JeyaVardhan-L/Single-Thrust-Vector-Controlled-Rocket/docs/glossary.md

# Glossary

| Term | Meaning |
|---|---|
| **AHRS** | Attitude and Heading Reference System: estimates orientation from gyro and accelerometer (here Mahony filter) |
| **Abort** | Software state entered on tilt > 35°, link loss, disarm or a fault in flight: motors cut, gimbal centred |
| **Backlash** | Free play between gear teeth or in a joint; shows up as dead-band in the thrust vector |
| **BEC** | Battery Eliminator Circuit: regulator that makes 5 V or 6 V from the flight battery |
| **CG / CP** | Centre of gravity / centre of pressure |
| **CRSF** | Crossfire serial protocol used by ExpressLRS receivers |
| **ELRS** | ExpressLRS, open-source RC link |
| **ESC** | Electronic speed controller for a brushless motor |
| **FRD** | Forward-Right-Down body axes |
| **FC** | Flight computer (Teensy 4.1 + sensors here) |
| **Gate** | A go / no-go checkpoint with written criteria |
| **Gimbal** | Two-axis pivot that swings the motor assembly to vector the thrust |
| **Coaxial pair** | Two motors on one axis with props turning in opposite directions, so their reaction torques cancel |
| **I (inertia)** | Moment of inertia about the pitch/yaw axis, kg·m² |
| **IMU** | Inertial measurement unit: gyro + accelerometer |
| **KV** | Motor constant, rpm per volt (no load) |
| **L (lever arm)** | Distance from the gimbal pivot to the CG |
| **LiPo** | Lithium-polymer battery |
| **Mahony filter** | Complementary attitude filter using accelerometer to correct gyro integration |
| **Mixer** | Maps roll/pitch/yaw commands to individual actuator commands |
| **PID** | Proportional-integral-derivative controller |
| **PLA / PETG / PA-CF** | 3D printing materials. PA-CF: nylon with carbon fibre |
| **RBF** | Remove-before-flight pin or loop that keeps the vehicle inert |
| **RSO** | Range Safety Officer |
| **Slew rate** | Maximum speed of an actuator, deg/s |
| **Thrust-to-weight (TWR)** | Thrust divided by weight |
| **TVC** | Thrust vector control |
| **Vane (jet vane)** | Control surface in the propeller or exhaust flow that deflects it sideways |
| **Wash** | The accelerated air stream behind a propeller |
