JeyaVardhan-L/Single-Thrust-Vector-Controlled-Rocket/assets/screenshots/monocopter-exploded.png

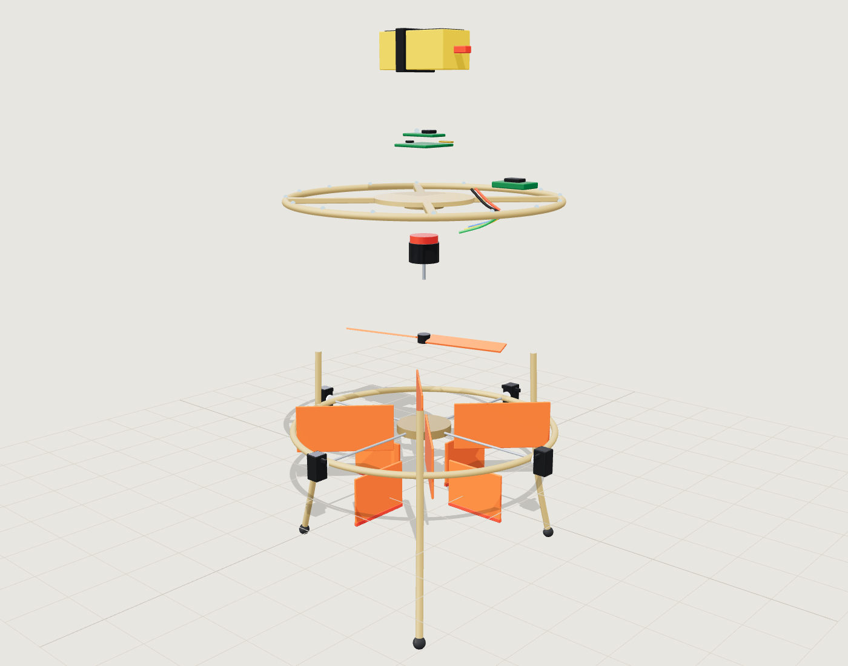
assets/screenshots/monocopter-exploded.png
