JeyaVardhan-L/Single-Thrust-Vector-Controlled-Rocket/assets/screenshots/ui-gimbal.png

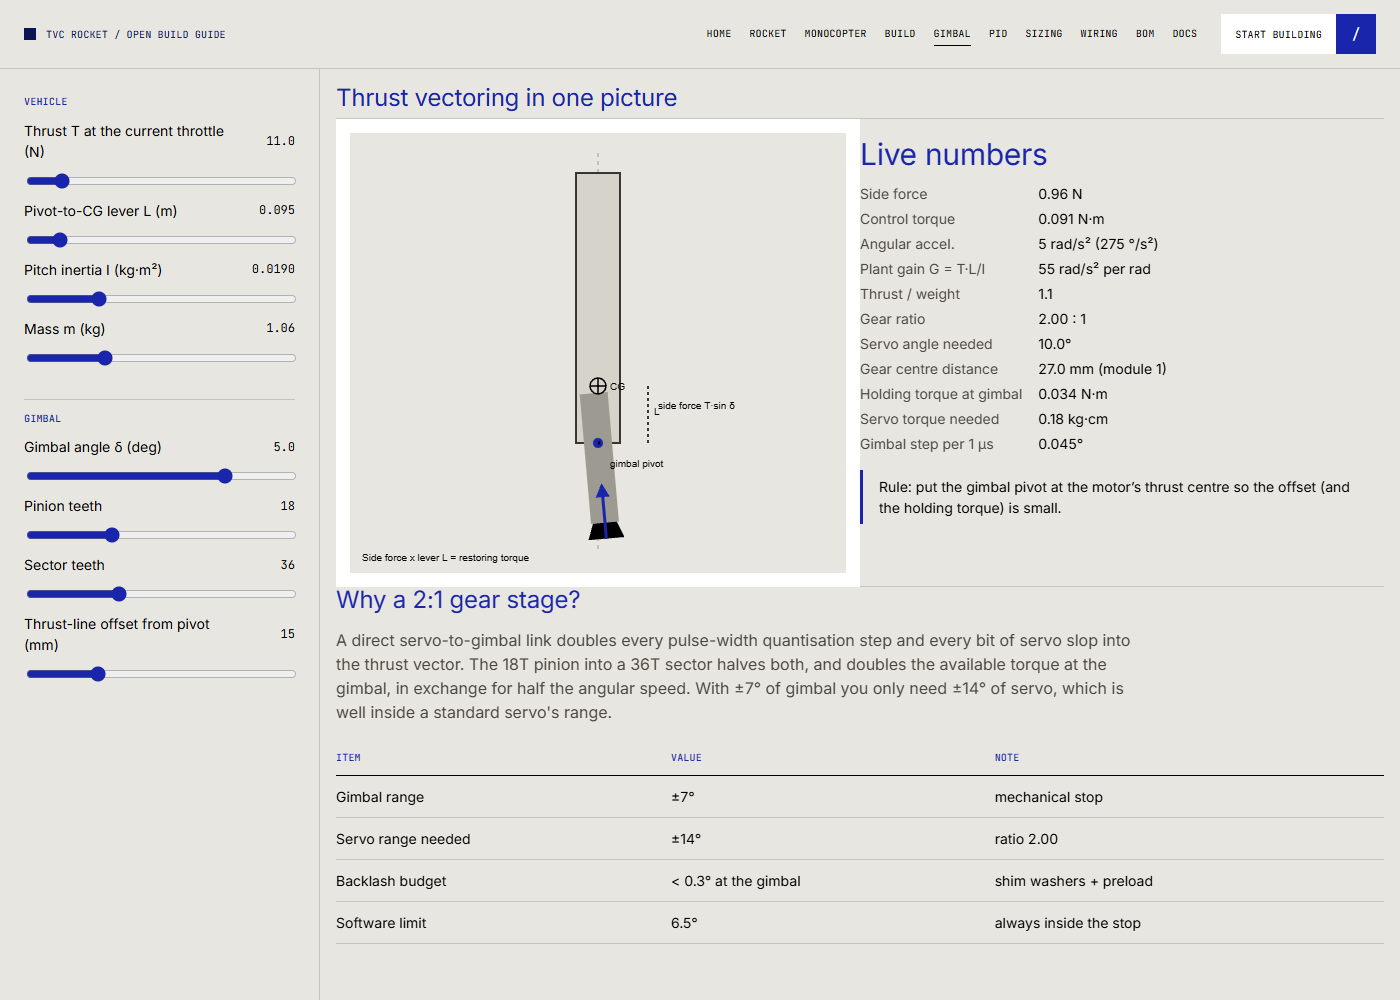
assets/screenshots/ui-gimbal.png
