JeyaVardhan-L/Single-Thrust-Vector-Controlled-Rocket/assets/screenshots/ui-index.png

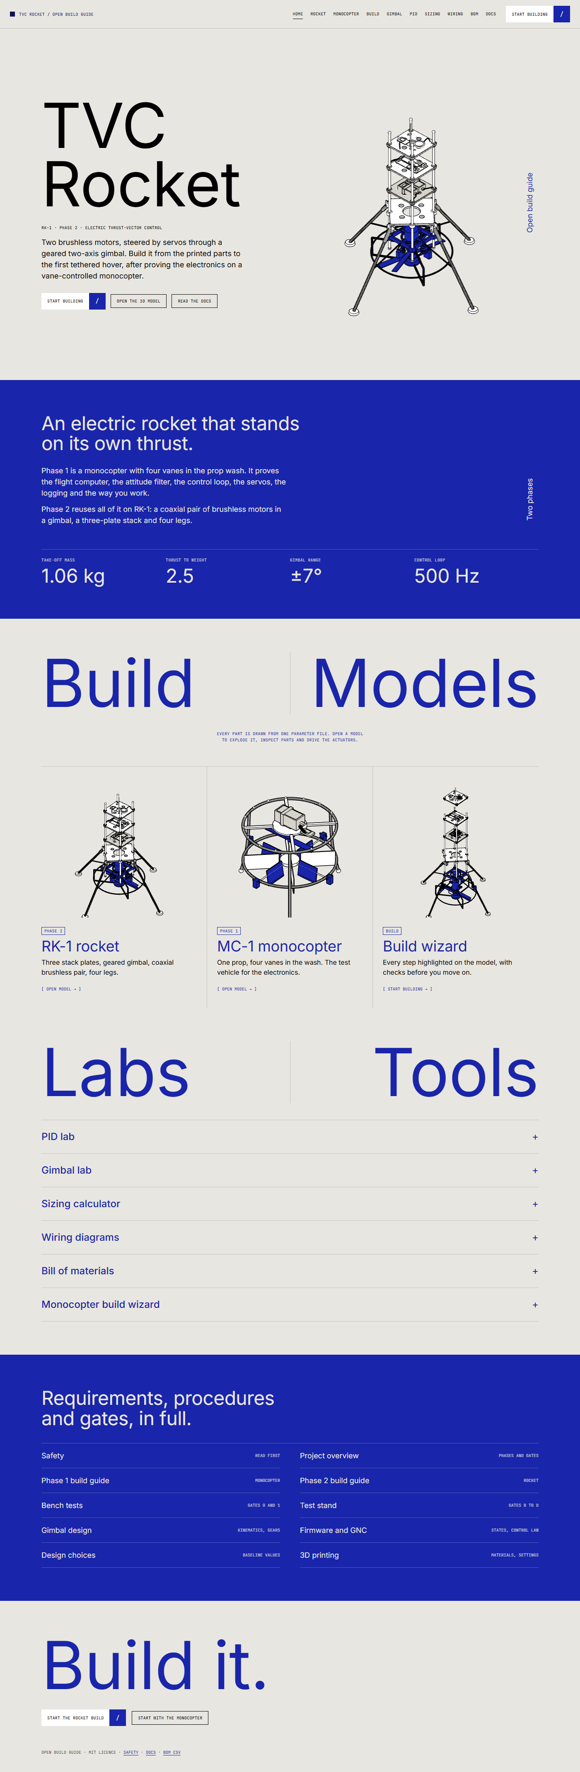
assets/screenshots/ui-index.png
