JeyaVardhan-L/Single-Thrust-Vector-Controlled-Rocket/assets/screenshots/ui-monocopter.png

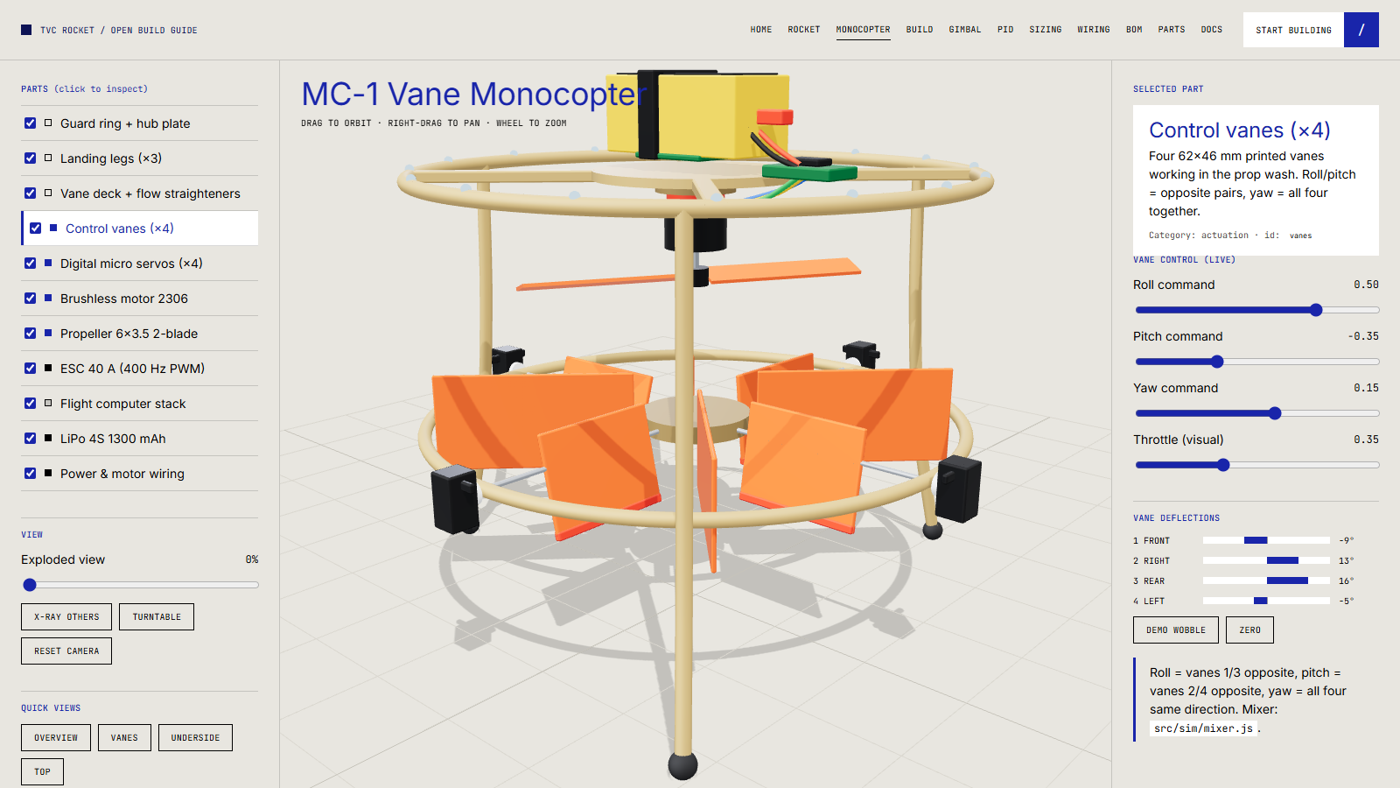
assets/screenshots/ui-monocopter.png
