JeyaVardhan-L/Single-Thrust-Vector-Controlled-Rocket/assets/screenshots/ui-pid.png

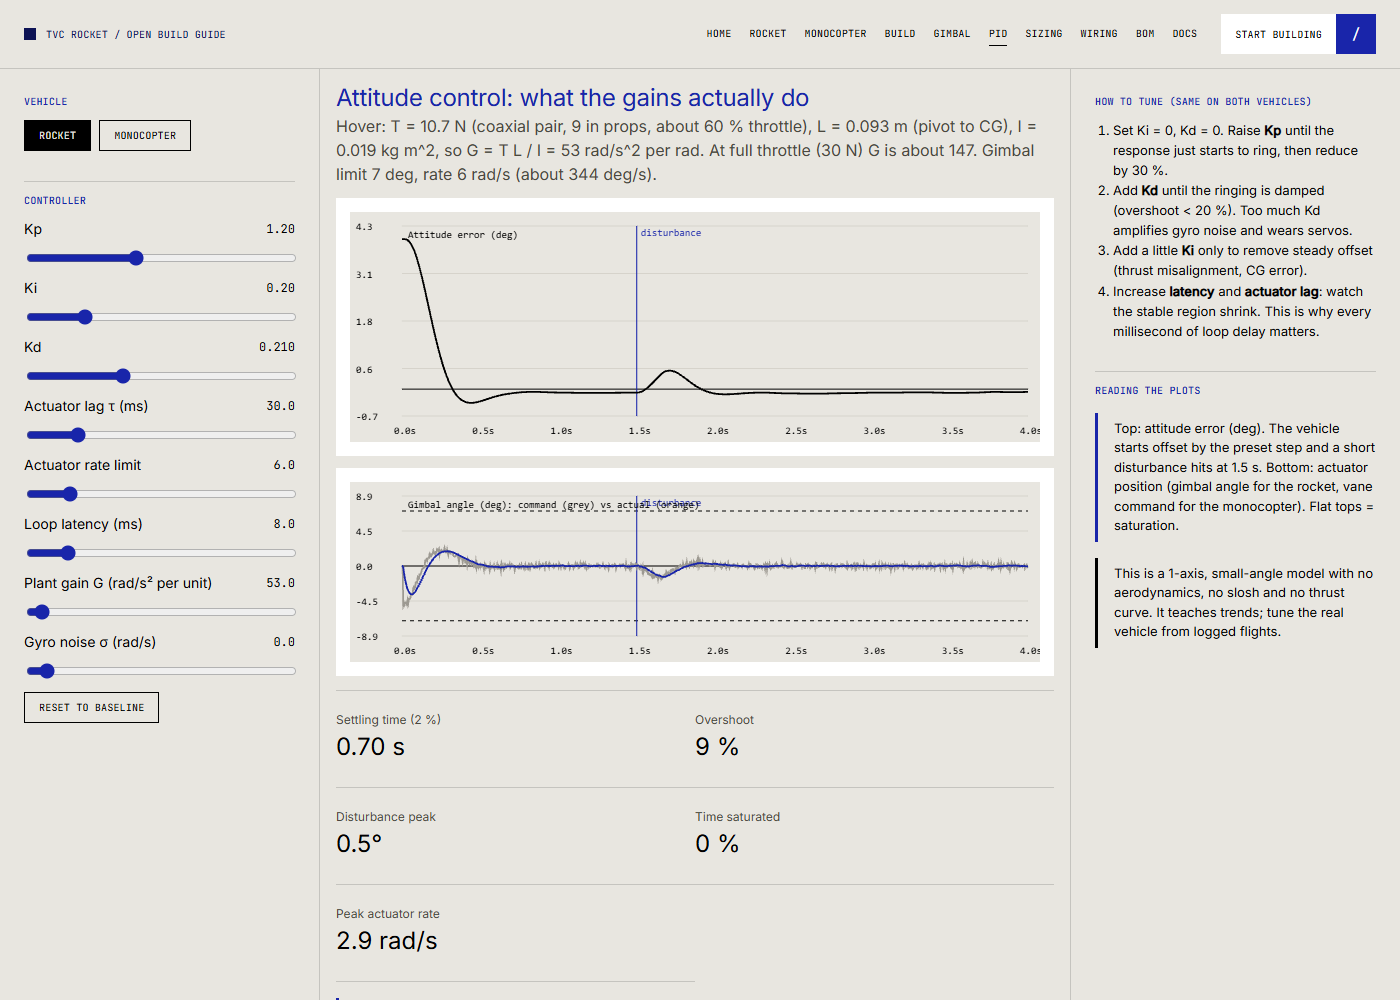
assets/screenshots/ui-pid.png
