JeyaVardhan-L/Single-Thrust-Vector-Controlled-Rocket/assets/screenshots/ui-rocket.png

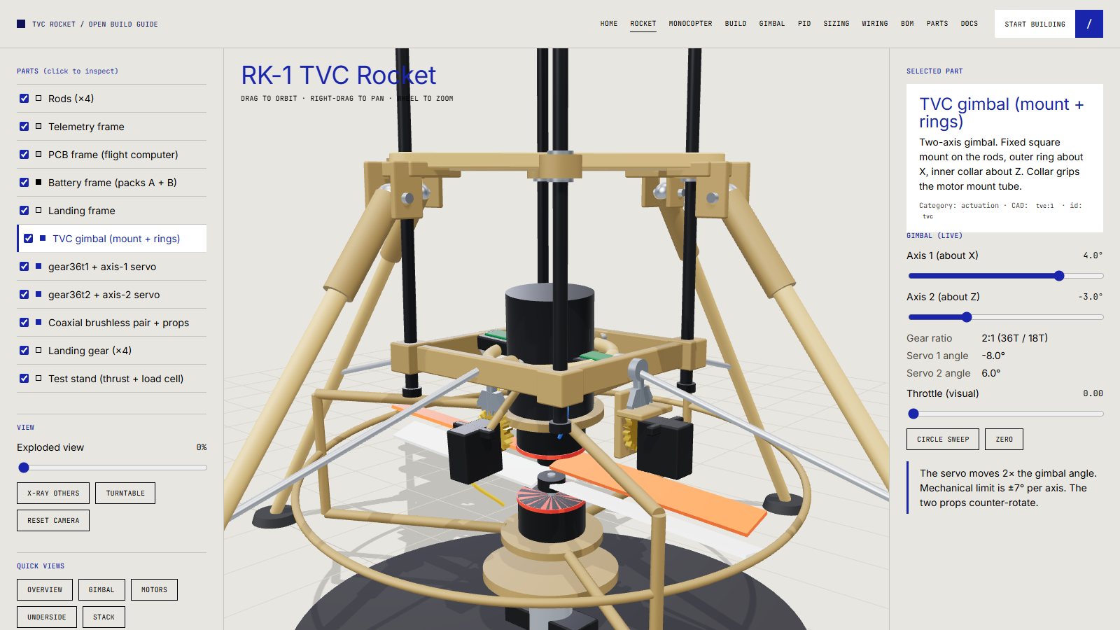
assets/screenshots/ui-rocket.png
