JeyaVardhan-L/Single-Thrust-Vector-Controlled-Rocket/assets/screenshots/ui-sizing.png

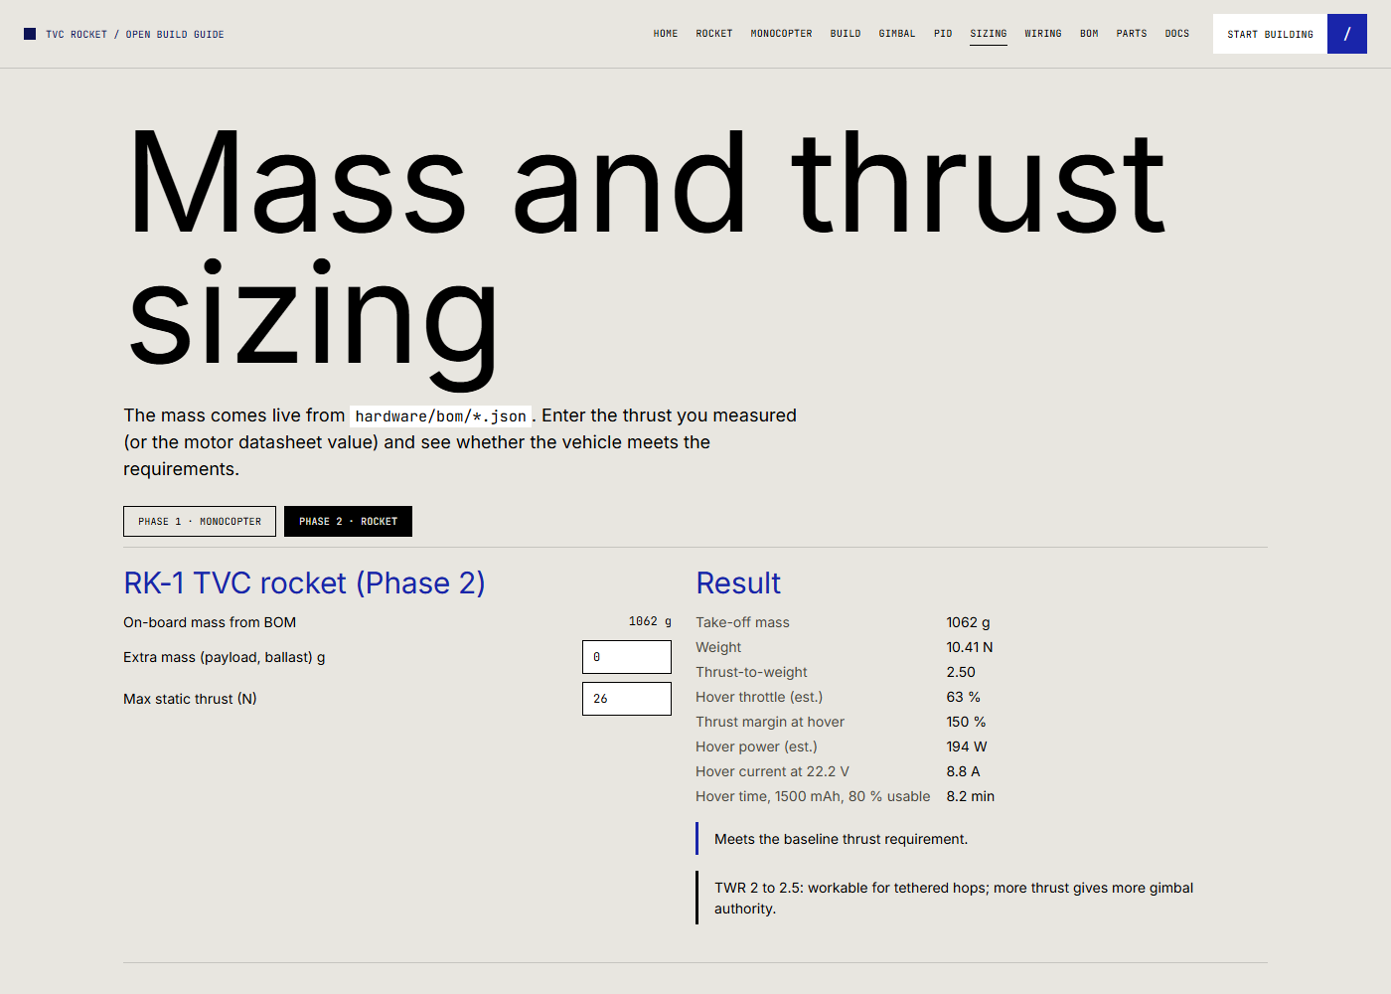
assets/screenshots/ui-sizing.png
