JeyaVardhan-L/Single-Thrust-Vector-Controlled-Rocket/docs/cad-parts.md

# Printable parts (STL)

Generated by `npm run cad` from [`scripts/cad/`](../scripts/cad/). Every file is a watertight solid in **millimetres**, already in its **print orientation** (z up, lowest face on the bed). Sizes are bounding boxes in that orientation. "g solid" is the mass if the part were printed 100 % solid, an upper bound: at the baseline settings (4 walls, 30 to 40 % infill) a part weighs roughly 55 to 80 % of it. Weigh the printed parts and update the BOM if a line differs by more than 10 % (see [printing guide](printing.md), post-processing step 6).

The smallest bed that fits everything is **220 × 220 mm**. Settings, materials and tolerances: [3D printing guide](printing.md).

## RK-1 rocket

| Part (STL) | Qty | Size (mm) | Material | g solid | BOM | Notes |
|---|---|---|---|---|---|---|
| [stack-plate-telemetry](../hardware/cad/stl/rocket/stack-plate-telemetry.stl) | 1 | 110 × 110 × 8 | PETG | 56 | R-02 | Ø6.2 rod holes with M3 clamp screws and nut slots; three M3 insert holes for the receiver / GPS standoffs. |
| [stack-plate-pcb](../hardware/cad/stl/rocket/stack-plate-pcb.stl) | 1 | 110 × 110 × 8 | PETG | 56 | R-02 | Four M3 insert holes at (±38, ±22) for the 9 mm standoffs under the carrier board. |
| [stack-plate-battery](../hardware/cad/stl/rocket/stack-plate-battery.stl) | 1 | 110 × 110 × 8 | PETG | 57 | R-02 | Two strap slots 12 × 3 mm at y = ±36. |
| [landing-frame](../hardware/cad/stl/rocket/landing-frame.stl) | 1 | 208 × 208 × 26.5 | PA-CF (or PETG for a first set) | 107 | R-03 | Printed upside down so the clevis ears point up. Hinge bore Ø3.2 for an M3 bolt. |
| [gimbal-mount](../hardware/cad/stl/rocket/gimbal-mount.stl) | 1 | 110 × 110 × 14 | PA-CF (or PETG for a first set) | 84 | G-01 | Carries the outer ring on two M3 pivots (X axis), the servo-1 bracket underneath and four leg-brace anchor holes. |
| [gimbal-ring](../hardware/cad/stl/rocket/gimbal-ring.stl) | 1 | 82 × 76 × 25 | PA-CF (or PETG for a first set) | 19 | G-01, G-02 | Printed upside down: sector fin points up. Two 683ZZ bearings in the X bosses; Y pads carry the collar pivots. Ream the Ø7 bearing bores. |
| [gimbal-collar](../hardware/cad/stl/rocket/gimbal-collar.stl) | 1 | 50 × 59.2 × 32 | PA-CF (or PETG for a first set) | 18 | G-01, G-02 | Clamps the Ø42 tube with four M3 set screws. Two 683ZZ bearings in the Y bosses. |
| [pinion-18t](../hardware/cad/stl/rocket/pinion-18t.stl) | 2 | 19.99 × 19.78 × 4 | PA12 / acetal (or metal) | 1 | G-02 | Ø4.7 bore for the 25T servo spline. Rotate on the spline until it meshes (gap centred on the sector tooth). |
| [servo-bracket-1](../hardware/cad/stl/rocket/servo-bracket-1.stl) | 1 | 31.5 × 36 × 14.5 | PA-CF (or PETG for a first set) | 5 | G-01 | Two M3 × 10 into the mount inserts; four M2 self-tap holes for a 23 × 12 mm servo. |
| [servo-bracket-2](../hardware/cad/stl/rocket/servo-bracket-2.stl) | 1 | 36 × 32.5 × 11.1 | PA-CF (or PETG for a first set) | 5 | G-01 | Two M3 × 10 into the ring inserts; four M2 self-tap holes for the servo. |
| [motor-plate-upper](../hardware/cad/stl/rocket/motor-plate-upper.stl) | 1 | 78.06 × 90.14 × 13 | PA-CF (or PETG for a first set) | 20 | M-05 | Ø42.3 socket for the carbon tube (epoxy + two M3 set screws). Motor pattern Ø19, four M3, reached through the tube bore. |
| [motor-plate-lower](../hardware/cad/stl/rocket/motor-plate-lower.stl) | 1 | 78.06 × 90.14 × 5 | PA-CF (or PETG for a first set) | 14 | M-05 | Motor B stands on it; screws from below. |
| [cage-arm-upper](../hardware/cad/stl/rocket/cage-arm-upper.stl) | 3 | 105 × 16 × 7.8 | PA-CF (or PETG for a first set) | 8 | M-05 | Half-lap onto the plate stub, two M3 × 12 with nuts; tip bolts to the strut. |
| [cage-arm-lower](../hardware/cad/stl/rocket/cage-arm-lower.stl) | 3 | 105 × 16 × 7.8 | PA-CF (or PETG for a first set) | 8 | M-05 | Same as the upper arm, on the lower plate. |
| [cage-strut](../hardware/cad/stl/rocket/cage-strut.stl) | 3 | 7.5 × 14 × 60 | PA-CF (or PETG for a first set) | 7 | M-05 | M3 inserts in both ends (screws M3 × 10 through the arms) and two on the outer face for the guard-ring tabs. |
| [guard-arc](../hardware/cad/stl/rocket/guard-arc.stl) | 3 | 195 × 125.98 × 10 | PETG | 9 | M-05 | Tabs screw onto the struts with M3 × 10. |
| [leg-hinge](../hardware/cad/stl/rocket/leg-hinge.stl) | 4 | 41.5 × 15 × 12.6 | PA-CF (or PETG for a first set) | 8 | R-04 | Ø8.2 socket for the Ø8 carbon leg (epoxy), Ø3.2 pin bore. Tongue 12.6 mm sits between the frame lug ears. |
| [leg-clip](../hardware/cad/stl/rocket/leg-clip.stl) | 4 | 27 × 18 × 10 | PETG | 3 | R-05 | Slides onto the leg, M3 grub screw; Ø2.2 eyelet for the Ø1.6 brace wire. |

Whole set printed solid: 583 g (upper bound).

## Hardware for the printed parts (RK-1)

| Item | Qty | Used at |
|---|---|---|
| M3 heat-set insert (Ø4.2 hole, 5.7 mm) | 23 | telemetry plate 3, PCB plate 4, gimbal mount 2, outer ring 2, cage struts 12 |
| M3 × 8 screw + M3 nut | 30 | rod clamps (3 plates, landing frame, mount: 20), collar set screws 4, motor plate socket 2, brace clips 4 |
| M3 × 20 bolt + M3 nylock nut | 2 | outer ring pivots (X axis) |
| M3 × 16 bolt + M3 nylock nut | 2 | collar pivots (Y axis) |
| M3 × 25 bolt + M3 nylock nut | 4 | leg hinges |
| M3 × 12 screw + M3 nut | 12 | cage arms to the plate stubs (two per arm) |
| M3 × 10 screw | 16 | servo brackets 4, arm tips to struts 6, guard-arc tabs 6 |
| M2 × 6 self-tapping screw | 8 | two servos, four per servo |
| 683ZZ bearing (3 × 7 × 3) | 4 | two in the outer ring bosses, two in the collar bosses |
| Carbon rod Ø6 × 400 mm | 4 | stack rods |
| Carbon rod Ø8 × 260 mm | 4 | legs |
| Carbon tube Ø42 (about 40 mm bore), 58 mm long | 1 | motor mount tube |
| Wire Ø1.6 mm | 4 | leg braces, about 135 mm each before the hooks |
