JeyaVardhan-L/Single-Thrust-Vector-Controlled-Rocket/docs/phase2-rocket/02-bom.md

<!-- GENERATED by scripts/gen-bom.mjs from hardware/bom/rocket.json. Edit the JSON, not this file. -->
# Bill of materials - Phase 2 - RK-1 TVC rocket

Masses are catalogue values; weigh each part as you build. Prices are indicative USD. Propulsion: coaxial contra-rotating brushless pair on a servo gimbal, see docs/design-choices.md.

| Total on-board mass | Total cost (all lines, indicative) |
|---|---|
| **1062 g** | **$746** |

Interactive version with live mass budget: [web/bom.html?model=rocket](../../web/bom.html?model=rocket). CSV: [rocket.csv](../../hardware/bom/rocket.csv).

## Structure

| ID | Item | Qty | Mass (g, each) | Price ($, each) | On-board | Specification / notes |
|---|---|---:|---:|---:|:---:|---|
| R-01 | Carbon-fibre rods, 6 mm x 400 mm | 4 | 23 | 4 | yes | Solid or thick-wall tube, 6 mm dia - Cut to 400 mm, deburr, seal ends with CA. |
| R-02 | Stack plates (battery, PCB, telemetry) | 3 | 22 | 3 | yes | PETG/PA-CF, 110 mm square, 4 mm thick - Print flat, 4 perimeters, 40% gyroid. |
| R-03 | Landing frame (diamond plate with four hinge lugs) | 1 | 38 | 4 | yes | PA-CF recommended: landing loads - 133 mm diamond, corners on the leg axes |
| R-04 | Landing legs 8 mm x 260 mm + rubber feet (hinge fittings printed) | 4 | 22 | 4 | yes | Carbon or aluminium tube, hinged at the corner lugs - 34 deg from vertical, footprint 510 mm |
| R-05 | Leg braces (1.6 mm steel or CF rod) | 4 | 3 | 1 | yes | From gimbal mount to leg mid-point |

## Gimbal

| ID | Item | Qty | Mass (g, each) | Price ($, each) | On-board | Specification / notes |
|---|---|---:|---:|---:|:---:|---|
| G-01 | Gimbal printed parts (mount, outer ring, collar, two servo brackets) | 1 | 48 | 6 | yes | PA-CF or machined 6061 aluminium - STL files in hardware/cad/stl/rocket. See docs/cad-parts.md. |
| G-02 | Pinion 18T, module 1 (printed PA12 / acetal, or metal) | 2 | 8 | 5 | yes | Acetal, nylon or printed PA; CAD names gear36t1 / gear36t2 - The two 36T sectors are printed into the outer ring and the collar. Check backlash; keep spares. |
| G-03 | Digital metal-gear servo, 20 g class, HV | 2 | 22 | 18 | yes | >= 4.5 kg.cm @ 7.4 V, <= 0.08 s/60 deg, 6-8.4 V rated - Buy a spare. |
| G-04 | Pivot hardware: M3 bolts (2 x 20 mm, 2 x 16 mm), nylock nuts, 683ZZ bearings | 4 | 3 | 1 | yes | Stainless button-head M3, 3x7x3 mm bearings (one per pivot) - Bolt is clamped to the fixed part, the bearing rides in the moving boss. Tighten until the bearing just drags, back off 1/8 turn. |
| G-05 | Service-loop cable for servo 2 | 1 | 3 | 1 | yes | Silicone wire, strain-relieved - Servo 2 rides on the outer ring. |

## Propulsion

| ID | Item | Qty | Mass (g, each) | Price ($, each) | On-board | Specification / notes |
|---|---|---:|---:|---:|:---:|---|
| M-01 | Brushless motor 3110, about 900 KV (coaxial pair) | 2 | 82 | 38 | yes | 6S rated, 5 mm shaft, prop adapters for CW and CCW - Static thrust about 1.5 kgf each with a 9 in prop on 6S (recorded on the stand at Gate B). |
| M-02 | Propellers 9x4.5, one CW and one CCW | 2 | 13 | 6 | yes | Matched pair, balanced. Upper prop (below its motor) is a pusher type, lower prop (above its motor) is a standard type; both blow air downward - Contra-rotating pair: reaction torques cancel. |
| M-03 | Spare propellers 9x4.5 (2 CW + 2 CCW) | 4 | 13 | 6 | no | Same as M-02 - The first crash breaks one. |
| M-04 | ESC 40 A, 6S, 400 Hz PWM (BLHeli_S / AM32) | 2 | 12 | 20 | yes | One per motor - Set the directions in the configurator before the first spin. |
| M-05 | Motor mount: Ø42 carbon tube, printed plates, arms, struts and guard ring | 1 | 52 | 10 | yes | Carbon tube 58 mm + printed plates, 3 struts and a Ø246 mm guard ring - Holds motor A above the props and motor B below. |
| M-06 | Power distribution board + 1000 uF 35 V capacitors + XT60 | 1 | 12 | 8 | yes | Two ESC feeds, capacitor close to each ESC |

## Power

| ID | Item | Qty | Mass (g, each) | Price ($, each) | On-board | Specification / notes |
|---|---|---:|---:|---:|:---:|---|
| E-01 | LiPo 6S 1500 mAh, 75C+, XT60 (main pack) | 1 | 215 | 42 | yes | 22.2 V nominal, 25.2 V full - Feeds the ESCs and, through BECs, the servos. |
| E-02 | LiPo 2S 450 mAh (avionics pack) | 1 | 35 | 9 | yes | 7.4 V nominal - Keeps the flight computer and log alive and electrically isolated from ESC noise. |
| E-03 | Servo BEC 7.4 V / 5 A (from the 6S pack) | 1 | 12 | 10 | yes | Switching regulator, input 6S, output 7.4 V - Servos are HV rated. |
| E-04 | 5 V / 3 A regulator (logic, from the 2S pack) | 1 | 5 | 6 | yes |  |
| E-05 | Fuse 5 A (servo BEC) + remove-before-flight pin + arm switch | 1 | 8 | 6 | yes | RBF pin breaks the main-pack supply: removable with gloves |
| E-06 | Wiring harness, connectors, heat shrink | 1 | 30 | 10 | yes | 12-14 AWG motor and power leads, 26-28 AWG signals, locking connectors - No bare Dupont connectors on a rocket: vibration. |

## Avionics

| ID | Item | Qty | Mass (g, each) | Price ($, each) | On-board | Specification / notes |
|---|---|---:|---:|---:|:---:|---|
| A-01 | Teensy 4.1 | 1 | 4 | 32 | yes |  |
| A-02 | IMU ICM-42688-P | 1 | 2 | 15 | yes | SPI, +-2000 dps, +-16 g - Mount near the stack axis. |
| A-03 | Barometer BMP390 | 1 | 1 | 8 | yes | Vent the frame; avoid sealed cavities. |
| A-04 | ExpressLRS 2.4 GHz receiver + antenna | 1 | 2 | 14 | yes | CRSF over UART, link statistics on the radio - Antenna on the top plate, clear of the carbon rods. |
| A-05 | GPS u-blox M10 module | 1 | 8 | 18 | yes | UART, 10 Hz - Top plate, antenna clear of carbon rods. |
| A-06 | Buzzer + status LEDs | 1 | 2 | 3 | yes |  |
| A-07 | microSD card | 1 | 0.5 | 6 | yes | FAT32/exFAT, 500 Hz logging - Logs are how you tune. |

## Hardware

| ID | Item | Qty | Mass (g, each) | Price ($, each) | On-board | Specification / notes |
|---|---|---:|---:|---:|:---:|---|
| H-01 | Fasteners (M3/M4/M5, nylock, washers, inserts) | 1 | 40 | 14 | yes | Counts per part are in docs/cad-parts.md (hardware list). About 23 M3 inserts, 75 M3 screws, 50 M3 nuts (8 nylock). |

## Test equipment

| ID | Item | Qty | Mass (g, each) | Price ($, each) | On-board | Specification / notes |
|---|---|---:|---:|---:|:---:|---|
| T-01 | Test stand: base, column, 20 kg load cell + HX711 | 1 | 0 | 45 | no | Steel/aluminium, anchored - See docs/phase2-rocket/07-test-stand-procedure.md |
| T-02 | Prop shield: polycarbonate panel or net cage | 1 | 0 | 25 | no | Between people and the props - Props shed fragments. |
| T-03 | Current-limited bench supply or smoke stopper | 1 | 0 | 25 | no | Limit to 2-3 A for the first power-up |
| T-04 | ELRS transmitter / radio | 1 | 0 | 80 | no | Any EdgeTX radio with an ELRS module - Skip if you already own one. |
| T-05 | Balance charger + LiPo safe bag (6S capable) | 1 | 0 | 50 | no |  |
| T-06 | Tether kit: 3 x 3 m line, anchors, swivel | 1 | 0 | 12 | no | Rated > 80 N |
| T-07 | Fire extinguisher, gloves, eye protection | 1 | 0 | 40 | no | Required at every powered test. |
