JeyaVardhan-L/Single-Thrust-Vector-Controlled-Rocket/docs/phase1-monocopter/02-bom.md

<!-- GENERATED by scripts/gen-bom.mjs from hardware/bom/monocopter.json. Edit the JSON, not this file. -->
# Bill of materials - Phase 1 - MC-1 monocopter

Masses are catalogue values and prices are indicative USD (hobby market, vary by region and supplier). Weigh each part as you build and update this file; the sizing page and the docs are generated from it.

| Total on-board mass | Total cost (all lines, indicative) |
|---|---|
| **485 g** | **$475** |

Interactive version with live mass budget: [web/bom.html?model=monocopter](../../web/bom.html?model=monocopter). CSV: [monocopter.csv](../../hardware/bom/monocopter.csv).

## Propulsion

| ID | Item | Qty | Mass (g, each) | Price ($, each) | On-board | Specification / notes |
|---|---|---:|---:|---:|:---:|---|
| P-01 | Brushless motor 2306, 1900-2300 KV | 1 | 33 | 22 | yes | 2306 outrunner, 4S rated, prop adapter, 16x16 or 12x12 mm mount pattern - Static thrust is recorded on the thrust stand at Gate 1. |
| P-02 | Propeller 6x3.5 two-blade (spares) | 3 | 6 | 2 | no | 6 in two-blade pusher type (air leaves away from the motor), rotation matched to the motor, balanced - Always keep spares: the first crash breaks one. |
| P-03 | Propeller (mounted) | 1 | 6 | 0 | yes | see P-02 - Balance with a prop balancer or tape trim. |
| P-04 | ESC 40 A, 4S, DShot (BLHeli_S / AM32) | 1 | 10 | 25 | yes | Single-motor ESC, DShot300/600 - Set motor direction in the configurator before the first spin. |

## Power

| ID | Item | Qty | Mass (g, each) | Price ($, each) | On-board | Specification / notes |
|---|---|---:|---:|---:|:---:|---|
| E-01 | LiPo 4S 1300 mAh, 75C+, XT60 | 1 | 155 | 28 | yes | 14.8 V nominal, 16.8 V full - Buy 2-3 packs. Store at 3.8 V per cell. |
| E-02 | Servo BEC 6.0 V / 5 A | 1 | 12 | 9 | yes | Switching regulator, input 2S-6S, output 6.0 V >= 5 A peak - Four digital servos can pull 3-4 A together at stall. |
| E-03 | Logic BEC 5 V / 3 A | 1 | 6 | 6 | yes | Low-noise 5 V for Teensy, IMU, receiver - Separate from the servo rail to avoid brown-outs. |
| E-04 | Power leads, XT60 pair, 14 AWG silicone | 1 | 14 | 6 | yes | Battery lead to ESC with 1000 uF 35 V low-ESR cap - Solder carefully; this is the highest-current joint. |
| E-05 | Arming switch + remove-before-flight loop | 1 | 5 | 5 | yes | XT30 loop or anti-spark switch in the battery lead - Nothing powers up until the loop is inserted. |
| E-06 | Voltage/current sensor (INA226 breakout) | 1 | 2 | 4 | yes | I2C, 36 V, shunt rated >= 40 A, or use ESC telemetry - Needed for battery-low cut and power logging. |

## Avionics

| ID | Item | Qty | Mass (g, each) | Price ($, each) | On-board | Specification / notes |
|---|---|---:|---:|---:|:---:|---|
| A-01 | Teensy 4.1 (with microSD slot) | 1 | 4 | 32 | yes | 600 MHz Cortex-M7, 3 SPI, 3 I2C, 8 UART - Same MCU as the rocket: Phase 1 de-risks the software. |
| A-02 | IMU ICM-42688-P breakout | 1 | 2 | 15 | yes | 6-axis, SPI, gyro +-2000 dps, accel +-16 g - Mount on foam standoffs at the CG, away from the motor. |
| A-03 | Barometer BMP390 breakout | 1 | 1 | 8 | yes | I2C/SPI, +-0.5 m relative - Cover with open-cell foam against prop-wash noise. |
| A-04 | ExpressLRS 2.4 GHz receiver | 1 | 1 | 14 | yes | CRSF over UART, telemetry back-channel - Needs a matching ELRS transmitter module/radio (ground equipment). |
| A-05 | microSD card 8-32 GB, class 10 | 1 | 0.5 | 6 | yes | FAT32/exFAT, flight log at 500 Hz - Logs are how you tune. Never fly without logging. |
| A-06 | Carrier board / perfboard + headers | 1 | 8 | 5 | yes | 70x70 mm max, female headers for the Teensy - Replace with a custom PCB once the pinout is frozen. |
| A-07 | Buzzer + status LEDs | 1 | 2 | 3 | yes | 5 V active buzzer, 3x LED - Audible arming state and low-battery alarm. |

## Actuation

| ID | Item | Qty | Mass (g, each) | Price ($, each) | On-board | Specification / notes |
|---|---|---:|---:|---:|:---:|---|
| S-01 | Digital metal-gear micro servo (9-13 g) | 4 | 13 | 9 | yes | >= 2.0 kg.cm at 6 V, <= 0.10 s/60 deg, 6 V rated, metal gear - Matched pairs for roll/pitch are a bonus. |
| S-02 | Servo spare | 1 | 13 | 9 | no | same as S-01 |
| S-03 | Vane hinge shaft, steel 2 mm x 110 mm | 4 | 3 | 1 | yes | 2 mm drill rod or carbon pin, cut to length - Servo horn clamps one end; vane clamps the shaft with an M2 grub screw. |

## Structure

| ID | Item | Qty | Mass (g, each) | Price ($, each) | On-board | Specification / notes |
|---|---|---:|---:|---:|:---:|---|
| F-01 | 3D-printed parts (PETG or PA-CF) | 1 | 105 | 12 | yes | Ring, hub, deck, vanes, legs, battery tray (see docs/printing.md) - Print legs in TPU or thin PETG for compliance. |
| F-02 | M3 stainless hardware kit + nylock nuts | 1 | 18 | 8 | yes | M3 x 6/8/12/16, washers, nylock |
| F-03 | M3 brass heat-set inserts | 40 | 0.1 | 0.12 | yes | M3 x 5.7 mm - Use a soldering iron with an insert tip. |
| F-04 | M2 screws + servo horn hardware | 1 | 3 | 3 | yes | M2 x 6/8, grub screws |
| F-05 | Battery strap 20 mm Velcro + foam pads | 1 | 4 | 2 | yes |  |
| F-06 | Wire: 26-30 AWG silicone, zip ties, heat shrink | 1 | 25 | 8 | yes |  |

## Test equipment

| ID | Item | Qty | Mass (g, each) | Price ($, each) | On-board | Specification / notes |
|---|---|---:|---:|---:|:---:|---|
| T-01 | Thrust stand: 5 kg load cell + HX711 | 1 | 0 | 12 | no | Bench thrust and torque measurement - Needed for Gate 1 (static thrust and vane authority). |
| T-02 | Tether kit: 3x 3 m line, ground anchors, swivel | 1 | 0 | 12 | no | Three-line tether, > 40 N working load - Slack tether limits altitude and sideways drift. |
| T-03 | Polycarbonate shield or net cage | 1 | 0 | 25 | no | Between operator and prop on the bench - Props at 15k rpm shed blades. |
| T-04 | Current-limited bench supply or smoke stopper | 1 | 0 | 25 | no | Limit to 2-3 A for first power-up - Protects against wiring shorts. |
| T-05 | LiPo safe bag + balance charger | 1 | 0 | 40 | no | 4S balance charger, fire-resistant bag |
| T-06 | ELRS transmitter / radio | 1 | 0 | 80 | no | Any EdgeTX radio with an ELRS module - Skip if you already own one. |
