JeyaVardhan-L/Single-Thrust-Vector-Controlled-Rocket/hardware/bom/rocket.csv

id | category | name | qty | onboard | unit_mass_g | unit_price_usd | line_mass_g | line_price_usd | spec | notes
R-01 | Structure | Carbon-fibre rods, 6 mm x 400 mm | 4 | yes | 23 | 4 | 92 | 16 | Solid or thick-wall tube, 6 mm dia | Cut to 400 mm, deburr, seal ends with CA.
R-02 | Structure | Stack plates (battery, PCB, telemetry) | 3 | yes | 22 | 3 | 66 | 9 | PETG/PA-CF, 110 mm square, 4 mm thick | Print flat, 4 perimeters, 40% gyroid.
R-03 | Structure | Landing frame (diamond plate with four hinge lugs) | 1 | yes | 38 | 4 | 38 | 4 | PA-CF recommended: landing loads | 133 mm diamond, corners on the leg axes
R-04 | Structure | Landing legs 8 mm x 260 mm + rubber feet (hinge fittings printed) | 4 | yes | 22 | 4 | 88 | 16 | Carbon or aluminium tube, hinged at the corner lugs | 34 deg from vertical, footprint 510 mm
R-05 | Structure | Leg braces (1.6 mm steel or CF rod) | 4 | yes | 3 | 1 | 12 | 4 | From gimbal mount to leg mid-point
G-01 | Gimbal | Gimbal printed parts (mount, outer ring, collar, two servo brackets) | 1 | yes | 48 | 6 | 48 | 6 | PA-CF or machined 6061 aluminium | STL files in hardware/cad/stl/rocket. See docs/cad-parts.md.
G-02 | Gimbal | Pinion 18T, module 1 (printed PA12 / acetal, or metal) | 2 | yes | 8 | 5 | 16 | 10 | Acetal, nylon or printed PA; CAD names gear36t1 / gear36t2 | The two 36T sectors are printed into the outer ring and the collar. Check backlash; keep spares.
G-03 | Gimbal | Digital metal-gear servo, 20 g class, HV | 2 | yes | 22 | 18 | 44 | 36 | >= 4.5 kg.cm @ 7.4 V, <= 0.08 s/60 deg, 6-8.4 V rated | Buy a spare.
G-04 | Gimbal | Pivot hardware: M3 bolts (2 x 20 mm, 2 x 16 mm), nylock nuts, 683ZZ bearings | 4 | yes | 3 | 1 | 12 | 4 | Stainless button-head M3, 3x7x3 mm bearings (one per pivot) | Bolt is clamped to the fixed part, the bearing rides in the moving boss. Tighten until the bearing just drags, back off 1/8 turn.
G-05 | Gimbal | Service-loop cable for servo 2 | 1 | yes | 3 | 1 | 3 | 1 | Silicone wire, strain-relieved | Servo 2 rides on the outer ring.
M-01 | Propulsion | Brushless motor 3110, about 900 KV (coaxial pair) | 2 | yes | 82 | 38 | 164 | 76 | 6S rated, 5 mm shaft, prop adapters for CW and CCW | Static thrust about 1.5 kgf each with a 9 in prop on 6S (recorded on the stand at Gate B).
M-02 | Propulsion | Propellers 9x4.5, one CW and one CCW | 2 | yes | 13 | 6 | 26 | 12 | Matched pair, balanced. Upper prop (below its motor) is a pusher type, lower prop (above its motor) is a standard type; both blow air downward | Contra-rotating pair: reaction torques cancel.
M-03 | Propulsion | Spare propellers 9x4.5 (2 CW + 2 CCW) | 4 | no | 13 | 6 | 0 | 24 | Same as M-02 | The first crash breaks one.
M-04 | Propulsion | ESC 40 A, 6S, 400 Hz PWM (BLHeli_S / AM32) | 2 | yes | 12 | 20 | 24 | 40 | One per motor | Set the directions in the configurator before the first spin.
M-05 | Propulsion | Motor mount: Ø42 carbon tube, printed plates, arms, struts and guard ring | 1 | yes | 52 | 10 | 52 | 10 | Carbon tube 58 mm + printed plates, 3 struts and a Ø246 mm guard ring | Holds motor A above the props and motor B below.
M-06 | Propulsion | Power distribution board + 1000 uF 35 V capacitors + XT60 | 1 | yes | 12 | 8 | 12 | 8 | Two ESC feeds, capacitor close to each ESC
E-01 | Power | LiPo 6S 1500 mAh, 75C+, XT60 (main pack) | 1 | yes | 215 | 42 | 215 | 42 | 22.2 V nominal, 25.2 V full | Feeds the ESCs and, through BECs, the servos.
E-02 | Power | LiPo 2S 450 mAh (avionics pack) | 1 | yes | 35 | 9 | 35 | 9 | 7.4 V nominal | Keeps the flight computer and log alive and electrically isolated from ESC noise.
E-03 | Power | Servo BEC 7.4 V / 5 A (from the 6S pack) | 1 | yes | 12 | 10 | 12 | 10 | Switching regulator, input 6S, output 7.4 V | Servos are HV rated.
E-04 | Power | 5 V / 3 A regulator (logic, from the 2S pack) | 1 | yes | 5 | 6 | 5 | 6
E-05 | Power | Fuse 5 A (servo BEC) + remove-before-flight pin + arm switch | 1 | yes | 8 | 6 | 8 | 6 | RBF pin breaks the main-pack supply: removable with gloves
E-06 | Power | Wiring harness, connectors, heat shrink | 1 | yes | 30 | 10 | 30 | 10 | 12-14 AWG motor and power leads, 26-28 AWG signals, locking connectors | No bare Dupont connectors on a rocket: vibration.
A-01 | Avionics | Teensy 4.1 | 1 | yes | 4 | 32 | 4 | 32
A-02 | Avionics | IMU ICM-42688-P | 1 | yes | 2 | 15 | 2 | 15 | SPI, +-2000 dps, +-16 g | Mount near the stack axis.
A-03 | Avionics | Barometer BMP390 | 1 | yes | 1 | 8 | 1 | 8 |  | Vent the frame; avoid sealed cavities.
A-04 | Avionics | ExpressLRS 2.4 GHz receiver + antenna | 1 | yes | 2 | 14 | 2 | 14 | CRSF over UART, link statistics on the radio | Antenna on the top plate, clear of the carbon rods.
A-05 | Avionics | GPS u-blox M10 module | 1 | yes | 8 | 18 | 8 | 18 | UART, 10 Hz | Top plate, antenna clear of carbon rods.
A-06 | Avionics | Buzzer + status LEDs | 1 | yes | 2 | 3 | 2 | 3
A-07 | Avionics | microSD card | 1 | yes | 0.5 | 6 | 0.5 | 6 | FAT32/exFAT, 500 Hz logging | Logs are how you tune.
H-01 | Hardware | Fasteners (M3/M4/M5, nylock, washers, inserts) | 1 | yes | 40 | 14 | 40 | 14 |  | Counts per part are in docs/cad-parts.md (hardware list). About 23 M3 inserts, 75 M3 screws, 50 M3 nuts (8 nylock).
T-01 | Test equipment | Test stand: base, column, 20 kg load cell + HX711 | 1 | no | 0 | 45 | 0 | 45 | Steel/aluminium, anchored | See docs/phase2-rocket/07-test-stand-procedure.md
T-02 | Test equipment | Prop shield: polycarbonate panel or net cage | 1 | no | 0 | 25 | 0 | 25 | Between people and the props | Props shed fragments.
T-03 | Test equipment | Current-limited bench supply or smoke stopper | 1 | no | 0 | 25 | 0 | 25 | Limit to 2-3 A for the first power-up
T-04 | Test equipment | ELRS transmitter / radio | 1 | no | 0 | 80 | 0 | 80 | Any EdgeTX radio with an ELRS module | Skip if you already own one.
T-05 | Test equipment | Balance charger + LiPo safe bag (6S capable) | 1 | no | 0 | 50 | 0 | 50
T-06 | Test equipment | Tether kit: 3 x 3 m line, anchors, swivel | 1 | no | 0 | 12 | 0 | 12 | Rated > 80 N
T-07 | Test equipment | Fire extinguisher, gloves, eye protection | 1 | no | 0 | 40 | 0 | 40 |  | Required at every powered test.
