JeyaVardhan-L/Single-Thrust-Vector-Controlled-Rocket/hardware/bom/monocopter.csv

id | category | name | qty | onboard | unit_mass_g | unit_price_usd | line_mass_g | line_price_usd | spec | notes
P-01 | Propulsion | Brushless motor 2306, 1900-2300 KV | 1 | yes | 33 | 22 | 33 | 22 | 2306 outrunner, 4S rated, prop adapter, 16x16 or 12x12 mm mount pattern | Static thrust is recorded on the thrust stand at Gate 1.
P-02 | Propulsion | Propeller 6x3.5 two-blade (spares) | 3 | no | 6 | 2 | 0 | 6 | 6 in two-blade pusher type (air leaves away from the motor), rotation matched to the motor, balanced | Always keep spares: the first crash breaks one.
P-03 | Propulsion | Propeller (mounted) | 1 | yes | 6 | 0 | 6 | 0 | see P-02 | Balance with a prop balancer or tape trim.
P-04 | Propulsion | ESC 40 A, 4S, DShot (BLHeli_S / AM32) | 1 | yes | 10 | 25 | 10 | 25 | Single-motor ESC, DShot300/600 | Set motor direction in the configurator before the first spin.
E-01 | Power | LiPo 4S 1300 mAh, 75C+, XT60 | 1 | yes | 155 | 28 | 155 | 28 | 14.8 V nominal, 16.8 V full | Buy 2-3 packs. Store at 3.8 V per cell.
E-02 | Power | Servo BEC 6.0 V / 5 A | 1 | yes | 12 | 9 | 12 | 9 | Switching regulator, input 2S-6S, output 6.0 V >= 5 A peak | Four digital servos can pull 3-4 A together at stall.
E-03 | Power | Logic BEC 5 V / 3 A | 1 | yes | 6 | 6 | 6 | 6 | Low-noise 5 V for Teensy, IMU, receiver | Separate from the servo rail to avoid brown-outs.
E-04 | Power | Power leads, XT60 pair, 14 AWG silicone | 1 | yes | 14 | 6 | 14 | 6 | Battery lead to ESC with 1000 uF 35 V low-ESR cap | Solder carefully; this is the highest-current joint.
E-05 | Power | Arming switch + remove-before-flight loop | 1 | yes | 5 | 5 | 5 | 5 | XT30 loop or anti-spark switch in the battery lead | Nothing powers up until the loop is inserted.
E-06 | Power | Voltage/current sensor (INA226 breakout) | 1 | yes | 2 | 4 | 2 | 4 | I2C, 36 V, shunt rated >= 40 A, or use ESC telemetry | Needed for battery-low cut and power logging.
A-01 | Avionics | Teensy 4.1 (with microSD slot) | 1 | yes | 4 | 32 | 4 | 32 | 600 MHz Cortex-M7, 3 SPI, 3 I2C, 8 UART | Same MCU as the rocket: Phase 1 de-risks the software.
A-02 | Avionics | IMU ICM-42688-P breakout | 1 | yes | 2 | 15 | 2 | 15 | 6-axis, SPI, gyro +-2000 dps, accel +-16 g | Mount on foam standoffs at the CG, away from the motor.
A-03 | Avionics | Barometer BMP390 breakout | 1 | yes | 1 | 8 | 1 | 8 | I2C/SPI, +-0.5 m relative | Cover with open-cell foam against prop-wash noise.
A-04 | Avionics | ExpressLRS 2.4 GHz receiver | 1 | yes | 1 | 14 | 1 | 14 | CRSF over UART, telemetry back-channel | Needs a matching ELRS transmitter module/radio (ground equipment).
A-05 | Avionics | microSD card 8-32 GB, class 10 | 1 | yes | 0.5 | 6 | 0.5 | 6 | FAT32/exFAT, flight log at 500 Hz | Logs are how you tune. Never fly without logging.
A-06 | Avionics | Carrier board / perfboard + headers | 1 | yes | 8 | 5 | 8 | 5 | 70x70 mm max, female headers for the Teensy | Replace with a custom PCB once the pinout is frozen.
A-07 | Avionics | Buzzer + status LEDs | 1 | yes | 2 | 3 | 2 | 3 | 5 V active buzzer, 3x LED | Audible arming state and low-battery alarm.
S-01 | Actuation | Digital metal-gear micro servo (9-13 g) | 4 | yes | 13 | 9 | 52 | 36 | >= 2.0 kg.cm at 6 V, <= 0.10 s/60 deg, 6 V rated, metal gear | Matched pairs for roll/pitch are a bonus.
S-02 | Actuation | Servo spare | 1 | no | 13 | 9 | 0 | 9 | same as S-01
S-03 | Actuation | Vane hinge shaft, steel 2 mm x 110 mm | 4 | yes | 3 | 1 | 12 | 4 | 2 mm drill rod or carbon pin, cut to length | Servo horn clamps one end; vane clamps the shaft with an M2 grub screw.
F-01 | Structure | 3D-printed parts (PETG or PA-CF) | 1 | yes | 105 | 12 | 105 | 12 | Ring, hub, deck, vanes, legs, battery tray (see docs/printing.md) | Print legs in TPU or thin PETG for compliance.
F-02 | Structure | M3 stainless hardware kit + nylock nuts | 1 | yes | 18 | 8 | 18 | 8 | M3 x 6/8/12/16, washers, nylock
F-03 | Structure | M3 brass heat-set inserts | 40 | yes | 0.1 | 0.12 | 4 | 4.8 | M3 x 5.7 mm | Use a soldering iron with an insert tip.
F-04 | Structure | M2 screws + servo horn hardware | 1 | yes | 3 | 3 | 3 | 3 | M2 x 6/8, grub screws
F-05 | Structure | Battery strap 20 mm Velcro + foam pads | 1 | yes | 4 | 2 | 4 | 2
F-06 | Structure | Wire: 26-30 AWG silicone, zip ties, heat shrink | 1 | yes | 25 | 8 | 25 | 8
T-01 | Test equipment | Thrust stand: 5 kg load cell + HX711 | 1 | no | 0 | 12 | 0 | 12 | Bench thrust and torque measurement | Needed for Gate 1 (static thrust and vane authority).
T-02 | Test equipment | Tether kit: 3x 3 m line, ground anchors, swivel | 1 | no | 0 | 12 | 0 | 12 | Three-line tether, > 40 N working load | Slack tether limits altitude and sideways drift.
T-03 | Test equipment | Polycarbonate shield or net cage | 1 | no | 0 | 25 | 0 | 25 | Between operator and prop on the bench | Props at 15k rpm shed blades.
T-04 | Test equipment | Current-limited bench supply or smoke stopper | 1 | no | 0 | 25 | 0 | 25 | Limit to 2-3 A for first power-up | Protects against wiring shorts.
T-05 | Test equipment | LiPo safe bag + balance charger | 1 | no | 0 | 40 | 0 | 40 | 4S balance charger, fire-resistant bag
T-06 | Test equipment | ELRS transmitter / radio | 1 | no | 0 | 80 | 0 | 80 | Any EdgeTX radio with an ELRS module | Skip if you already own one.
