JeyaVardhan-L/Single-Thrust-Vector-Controlled-Rocket/assets/screenshots/ui-bom.png

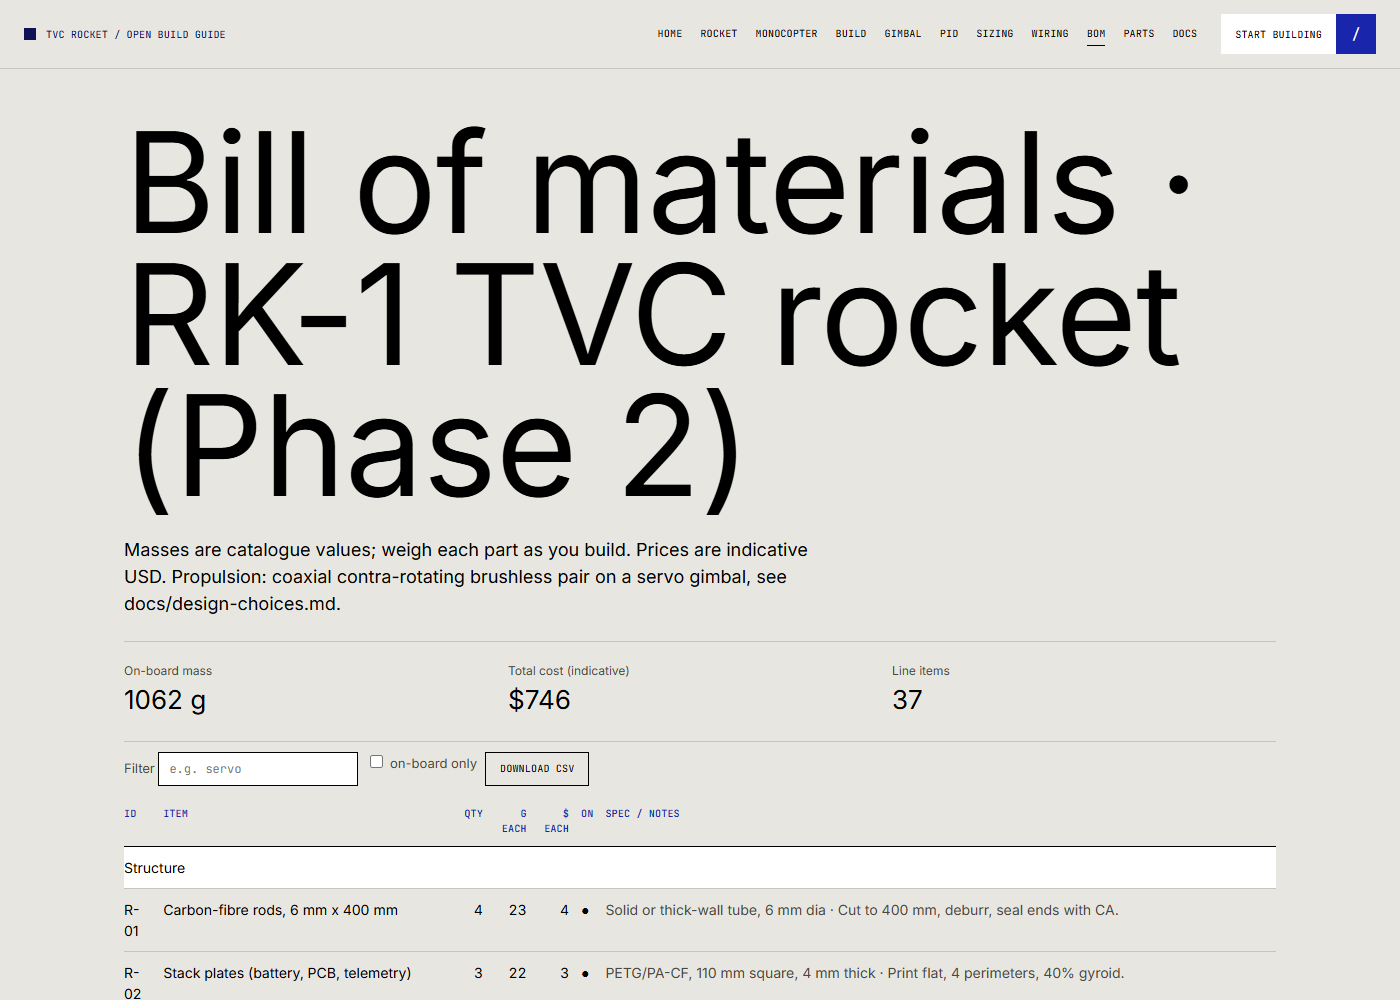
assets/screenshots/ui-bom.png
