JeyaVardhan-L/Single-Thrust-Vector-Controlled-Rocket/assets/screenshots/ui-parts.png

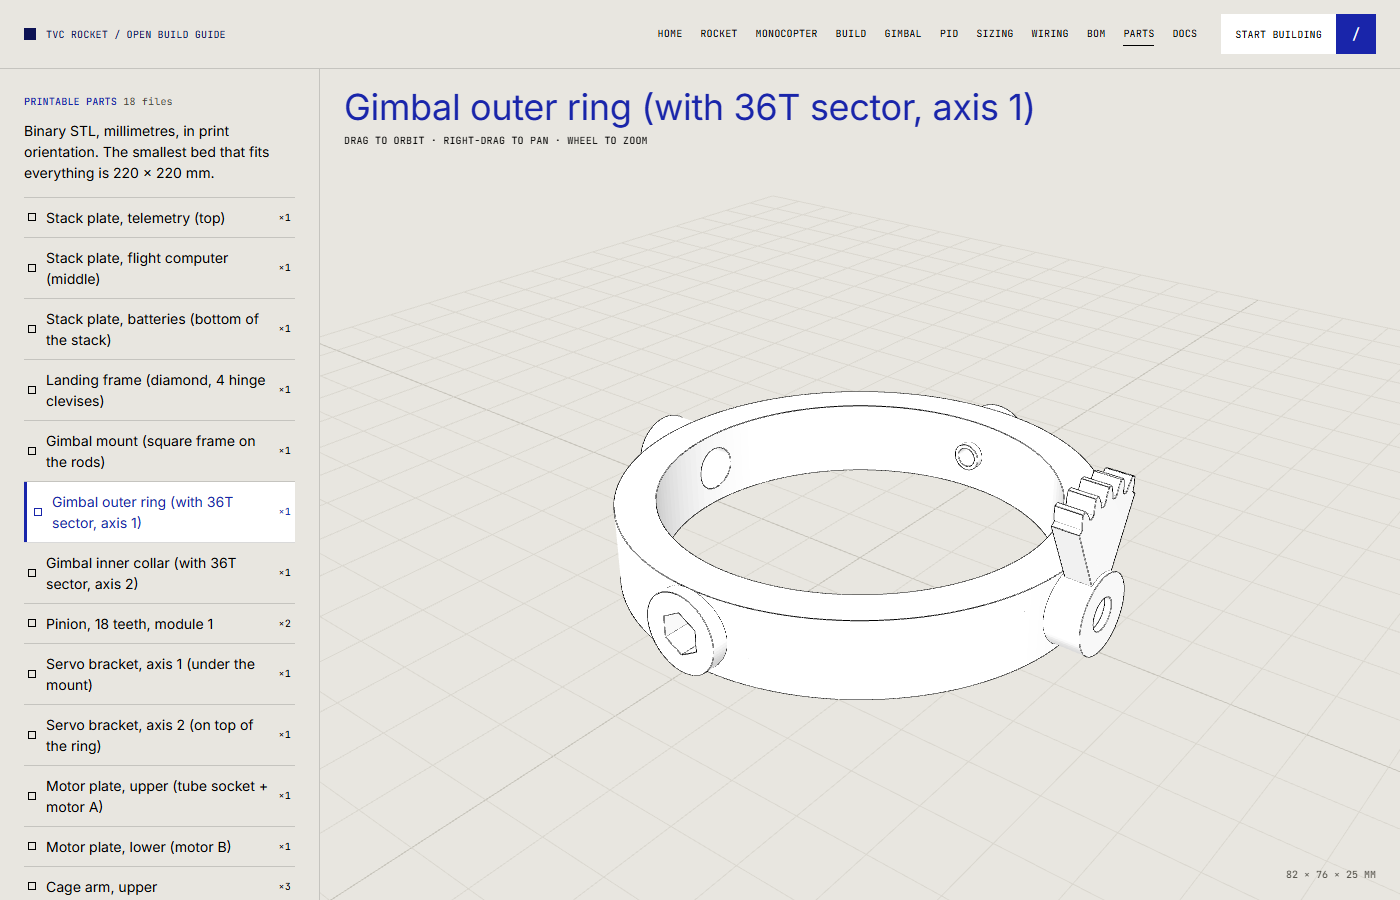
assets/screenshots/ui-parts.png
