JeyaVardhan-L/Single-Thrust-Vector-Controlled-Rocket/hardware/cad/stl/rocket/gimbal-ring.stl

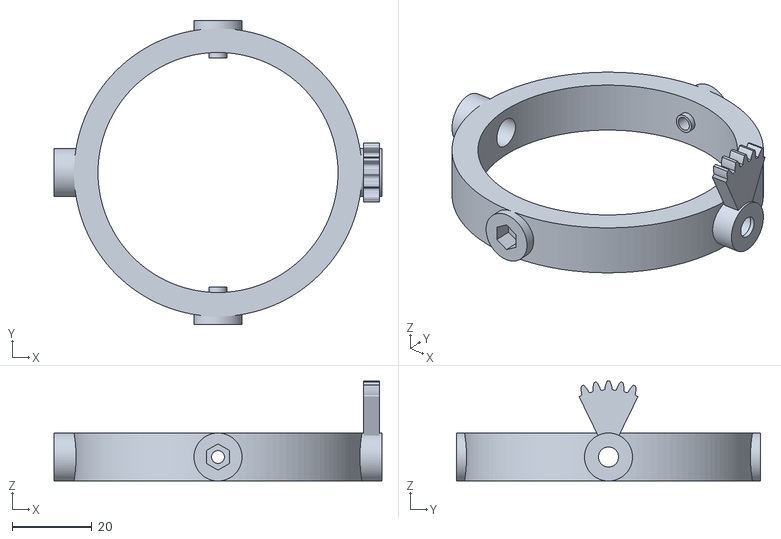
[picture p14: CAD file, 2026-11-10]
hardware/cad/stl/rocket/gimbal-ring.stl
82.0 x 76.0 x 25.0
