JeyaVardhan-L/Single-Thrust-Vector-Controlled-Rocket/hardware/cad/stl/rocket/servo-bracket-1.stl

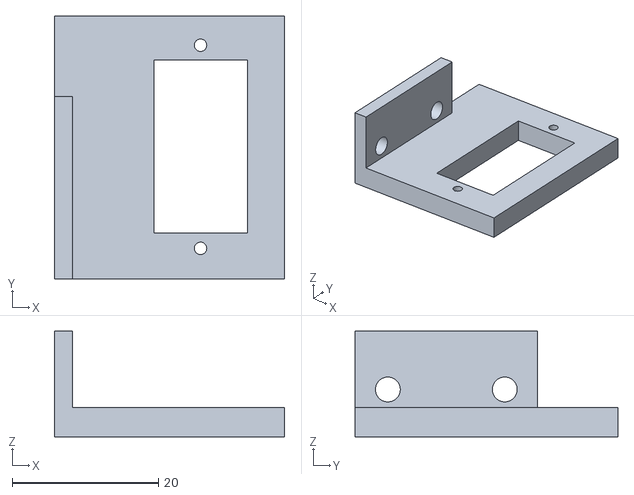
[picture p15: CAD file, 2026-11-10]
hardware/cad/stl/rocket/servo-bracket-1.stl
31.5 x 36.0 x 14.5
