JeyaVardhan-L/Single-Thrust-Vector-Controlled-Rocket/hardware/cad/stl/rocket/motor-plate-lower.stl

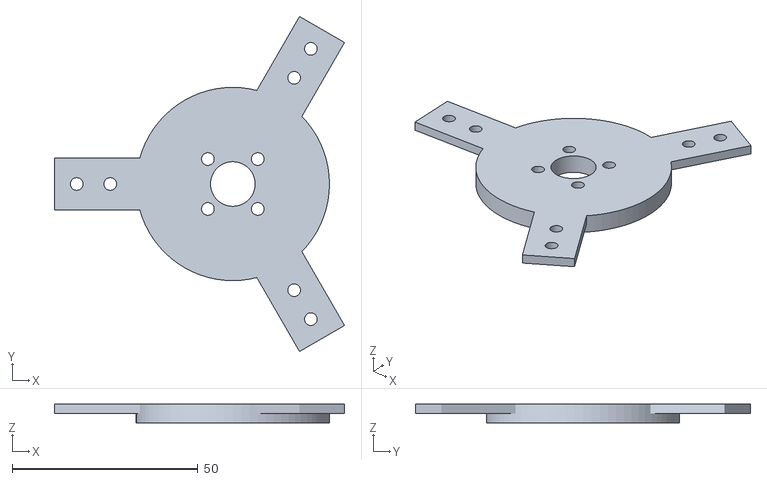
[picture p16: CAD file, 2026-11-10]
hardware/cad/stl/rocket/motor-plate-lower.stl
78.1 x 90.1 x 5.00
