JeyaVardhan-L/Single-Thrust-Vector-Controlled-Rocket/hardware/cad/stl/rocket/pinion-18t.stl

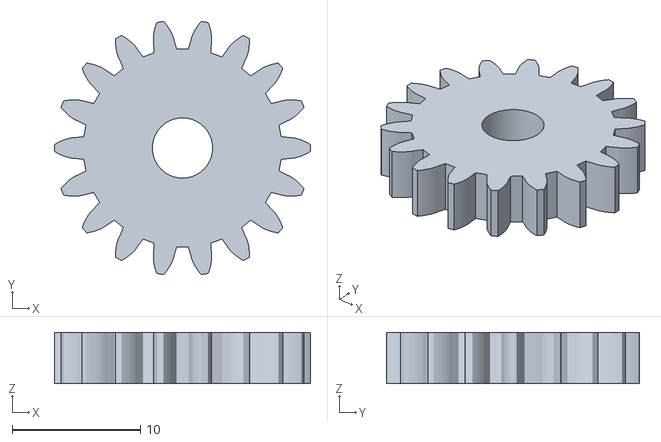
[picture p17: CAD file, 2026-11-10]
hardware/cad/stl/rocket/pinion-18t.stl
20.0 x 19.8 x 4.00
