JeyaVardhan-L/Single-Thrust-Vector-Controlled-Rocket/hardware/cad/stl/rocket/gimbal-mount.stl

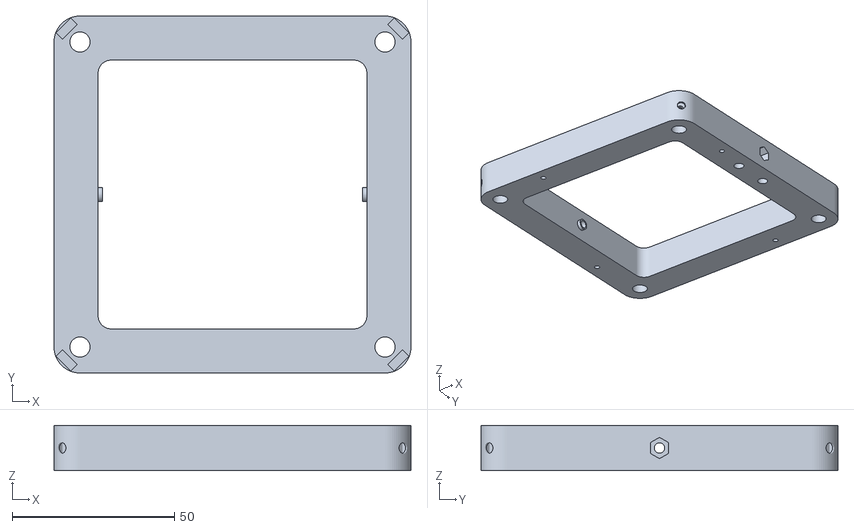
[picture p18: CAD file, 2026-11-10]
hardware/cad/stl/rocket/gimbal-mount.stl
110.0 x 110.0 x 14.0
