JeyaVardhan-L/Single-Thrust-Vector-Controlled-Rocket/hardware/cad/stl/rocket/guard-arc.stl

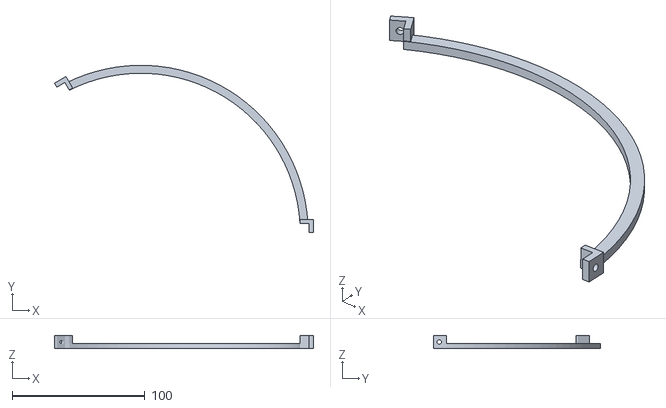
[picture p19: CAD file, 2026-11-10]
hardware/cad/stl/rocket/guard-arc.stl
195.0 x 126.0 x 10.0
