JeyaVardhan-L/Single-Thrust-Vector-Controlled-Rocket/hardware/cad/stl/rocket/motor-plate-upper.stl

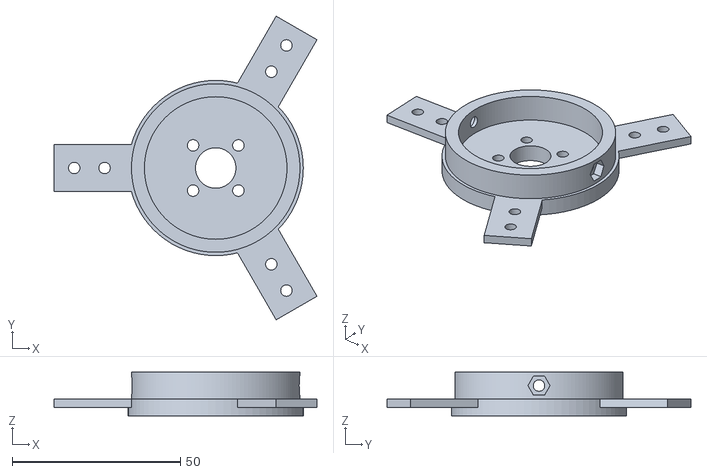
[picture p20: CAD file, 2026-11-10]
hardware/cad/stl/rocket/motor-plate-upper.stl
78.1 x 90.1 x 13.0
