JeyaVardhan-L/Single-Thrust-Vector-Controlled-Rocket/hardware/cad/stl/rocket/stack-plate-battery.stl

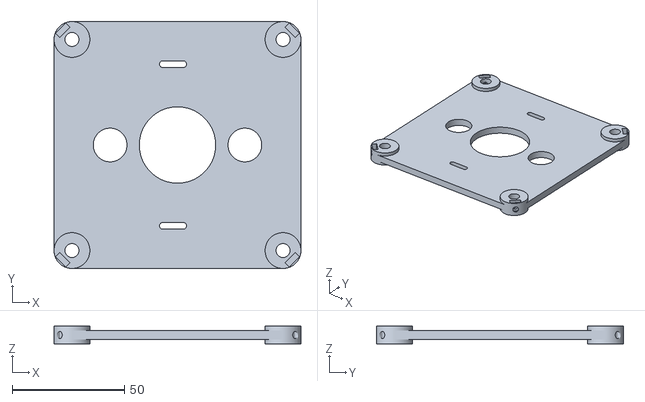
[picture p21: CAD file, 2026-11-10]
hardware/cad/stl/rocket/stack-plate-battery.stl
110.0 x 110.0 x 8.00
