JeyaVardhan-L/Single-Thrust-Vector-Controlled-Rocket/hardware/cad/stl/rocket/servo-bracket-2.stl

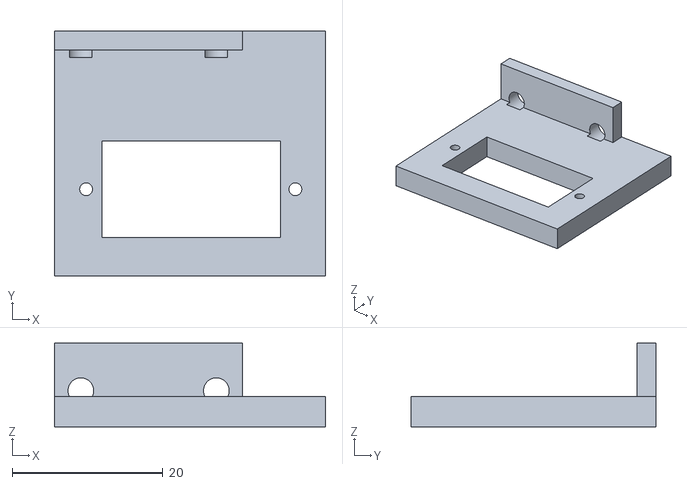
[picture p22: CAD file, 2026-11-10]
hardware/cad/stl/rocket/servo-bracket-2.stl
36.0 x 32.5 x 11.1
