JeyaVardhan-L/Single-Thrust-Vector-Controlled-Rocket/hardware/cad/stl/rocket/gimbal-collar.stl

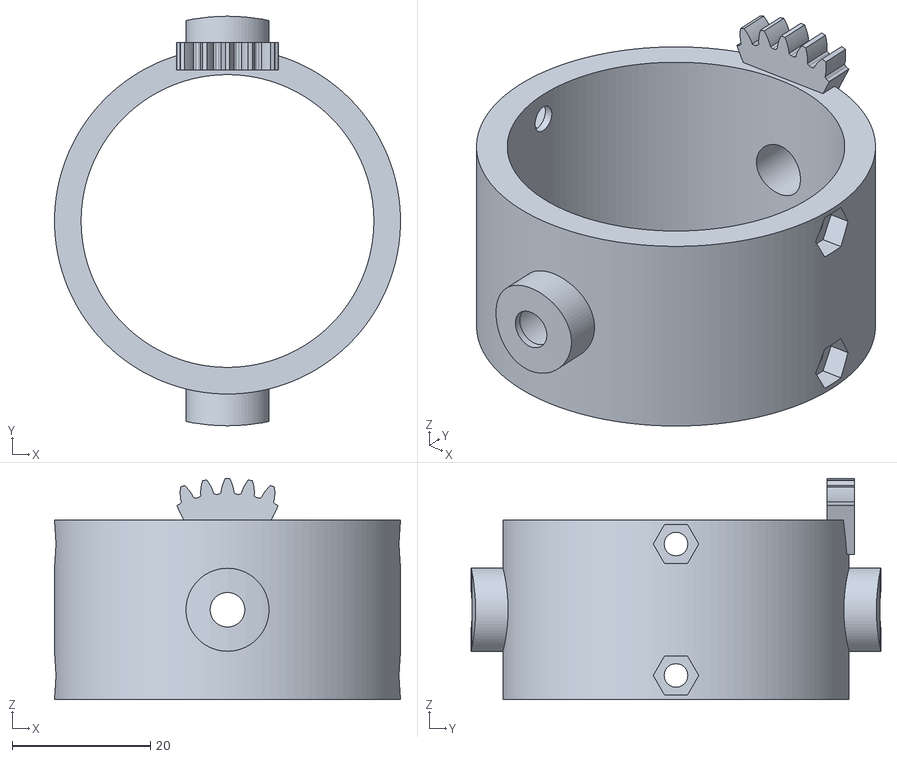
[picture p23: CAD file, 2026-11-10]
hardware/cad/stl/rocket/gimbal-collar.stl
50.0 x 59.2 x 32.0
