JeyaVardhan-L/Single-Thrust-Vector-Controlled-Rocket/hardware/cad/stl/rocket/cage-strut.stl

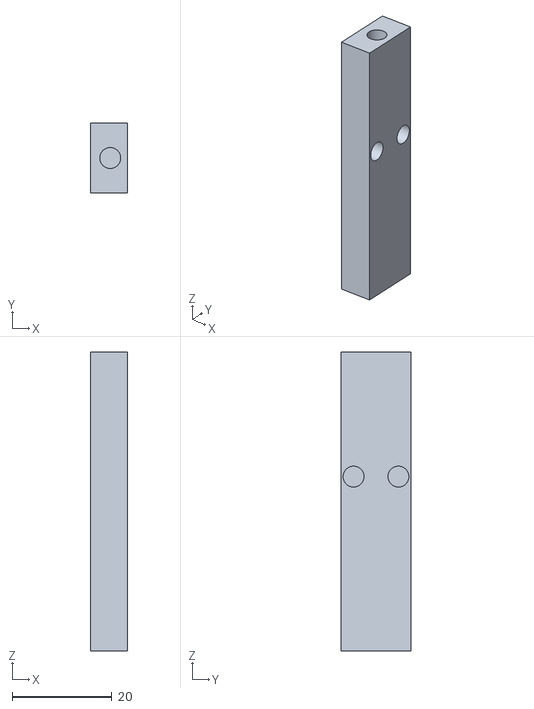
[picture p24: CAD file, 2026-11-10]
hardware/cad/stl/rocket/cage-strut.stl
7.50 x 14.0 x 60.0
