JeyaVardhan-L/Single-Thrust-Vector-Controlled-Rocket/hardware/cad/stl/rocket/landing-frame.stl

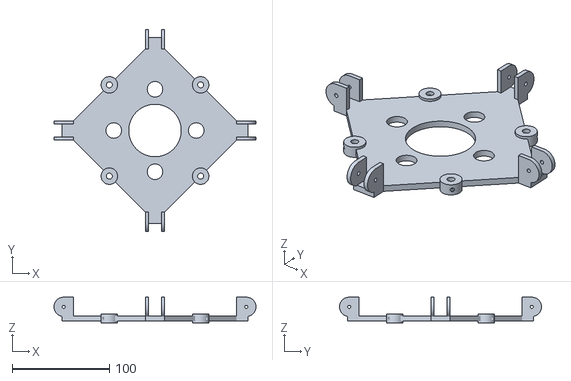
[picture p25: CAD file, 2026-11-10]
hardware/cad/stl/rocket/landing-frame.stl
208.0 x 208.0 x 26.5
