JeyaVardhan-L/Single-Thrust-Vector-Controlled-Rocket/hardware/cad/stl/rocket/cage-arm-upper.stl

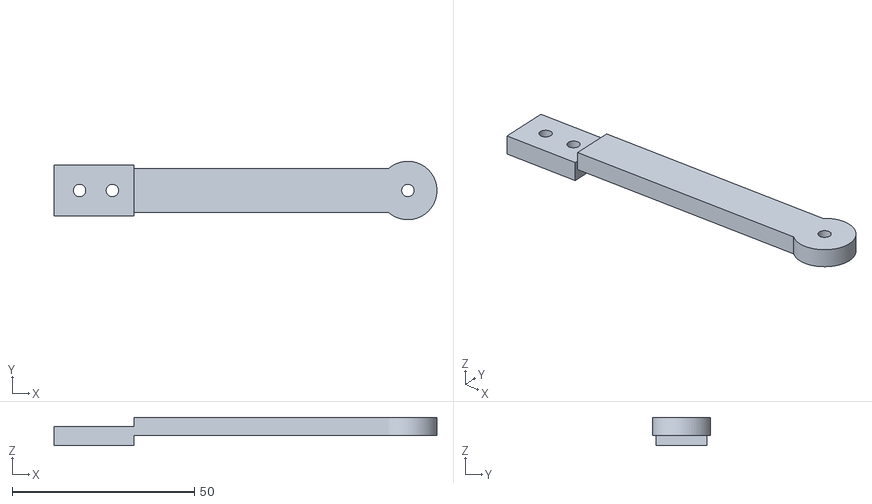
[picture p26: CAD file, 2026-11-10]
hardware/cad/stl/rocket/cage-arm-upper.stl
105.0 x 16.0 x 7.80
