JeyaVardhan-L/Single-Thrust-Vector-Controlled-Rocket/hardware/cad/stl/rocket/leg-clip.stl

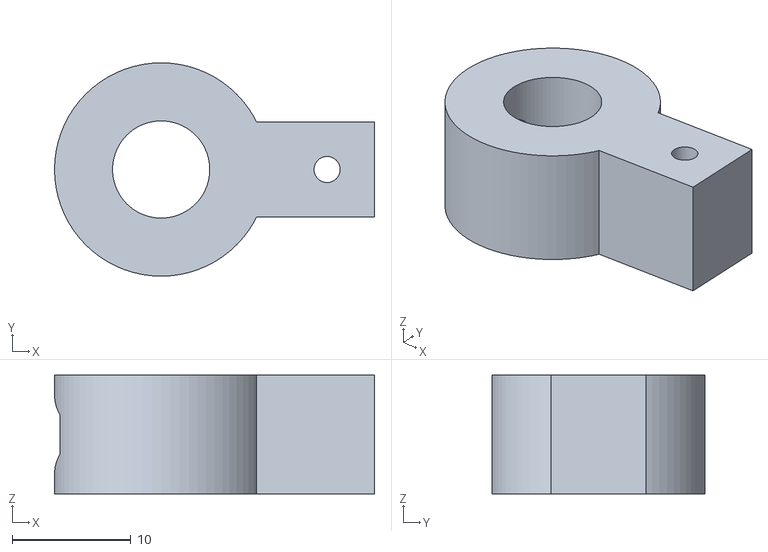
[picture p27: CAD file, 2026-11-10]
hardware/cad/stl/rocket/leg-clip.stl
27.0 x 18.0 x 10.0
