JeyaVardhan-L/Single-Thrust-Vector-Controlled-Rocket/hardware/cad/stl/rocket/leg-hinge.stl

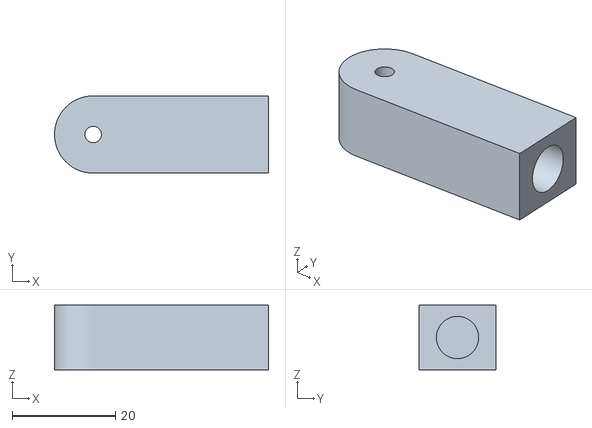
[picture p28: CAD file, 2026-11-10]
hardware/cad/stl/rocket/leg-hinge.stl
41.5 x 15.0 x 12.6
