JeyaVardhan-L/Single-Thrust-Vector-Controlled-Rocket/(list of files, cad)

Other CAD files:
hardware/cad/stl/rocket/stack-plate-telemetry.stl
hardware/cad/stl/rocket/stack-plate-pcb.stl
hardware/cad/stl/rocket/cage-arm-lower.stl
