JeyaVardhan-L/Single-Thrust-Vector-Controlled-Rocket/assets/screenshots/ui-wiring.png

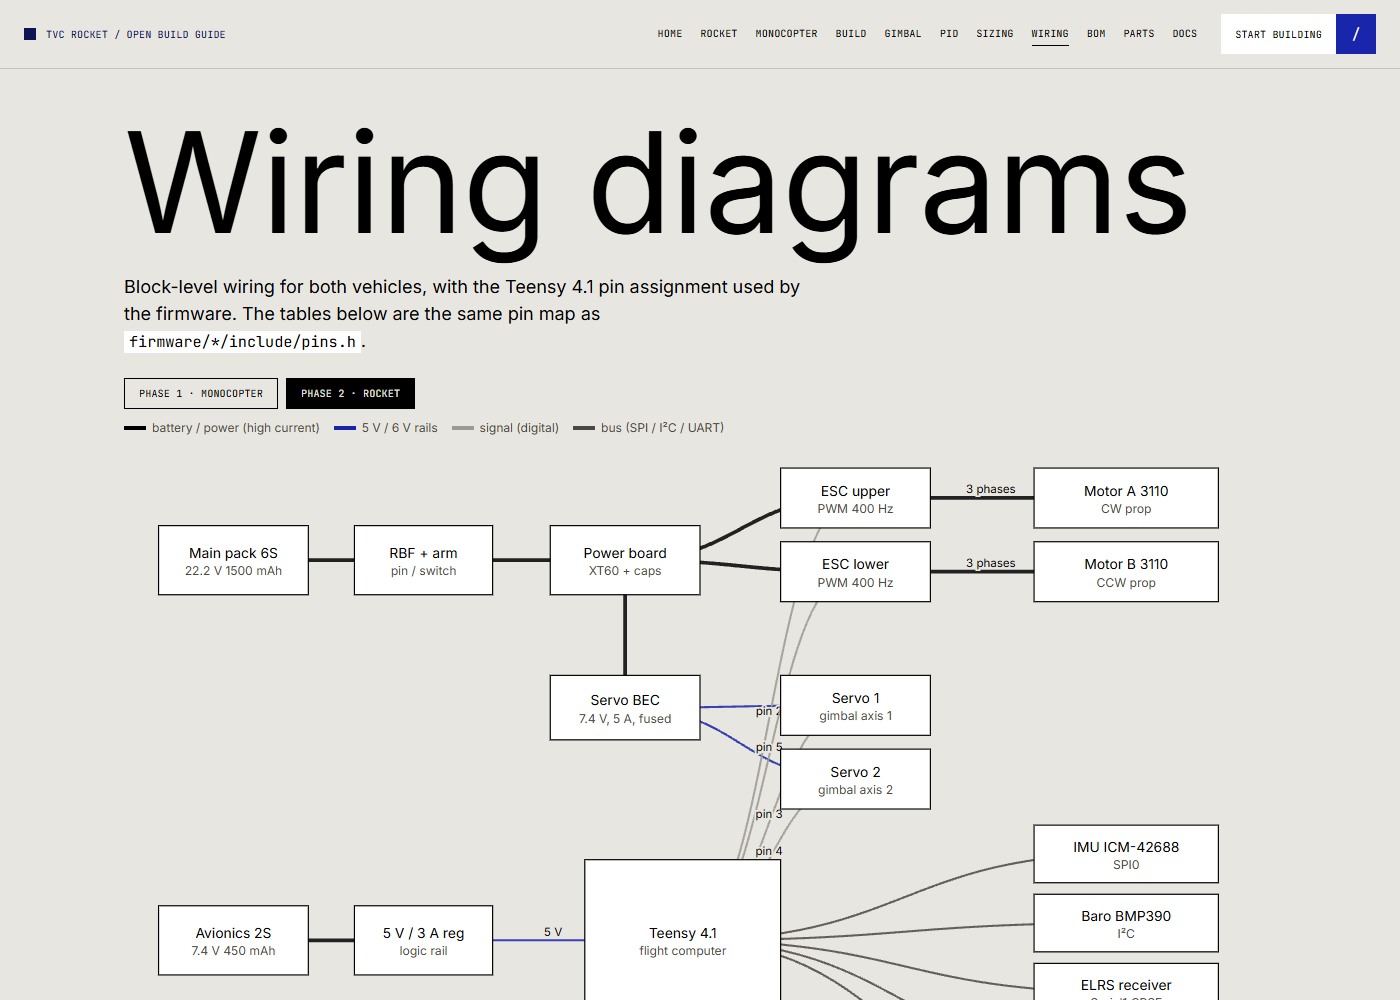
assets/screenshots/ui-wiring.png
