JeyaVardhan-L/Single-Thrust-Vector-Controlled-Rocket/src/data/steps.js

// Build-guide step data for the interactive assembly wizard (web/assembly.html).
// `adds` = parts that appear at this step, `focus` = parts highlighted (defaults to adds).
// The long-form procedure lives in docs/phase*/03-build-guide.md; keep both in sync.

export const STEPS = {
  monocopter: {
    title: 'MC-1 Monocopter - build guide',
    doc: '../docs/phase1-monocopter/03-build-guide.md',
    steps: [
      { title: 'Print and prepare the structure', adds: ['frame-ring'], time: '≈ 8 h print, 30 min prep',
        do: ['Print the guard ring + hub plate flat in PETG (or PA-CF): 0.2 mm layers, 4 perimeters, 30 % gyroid.',
             'Remove brims, deburr every hole with a 3 mm drill by hand, test-fit an M3 screw in each.',
             'Install M3 brass heat-set inserts in the hub plate (motor mount, FC standoffs) with a soldering iron at ≈ 220 °C, pressing straight until flush.'],
        check: ['Ring is flat on a table (no warp > 1 mm).', 'All inserts flush and square.'],
        warn: 'Printed parts are the structure: reprint anything with visible layer splits.' },
      { title: 'Attach the legs and vane deck', adds: ['legs', 'vane-deck'], time: '45 min',
        do: ['Bolt the three legs to the guard ring at 120° spacing; rubber caps on the feet.',
             'Fit the vane deck ring below the guard ring using the leg brackets (deck sits 113 mm below the guard ring).',
             'Press the four 2 mm steel hinge shafts through the deck ring and centre hub; they must spin freely.'],
        check: ['Hinge shafts are co-planar and spin with a fingertip.', 'Frame stands level on its three legs.'] },
      { title: 'Servos and control vanes', adds: ['servos', 'vanes'], time: '1 h',
        do: ['Centre each servo electrically first (1500 µs) BEFORE fitting the horn.',
             'Mount servos on the outside of the deck ring (X pattern: front, right, rear, left).',
             'Clamp each vane on its hinge shaft with the M2 grub screw, vane exactly vertical when the servo is centred.',
             'Label servo leads 1 front, 2 right, 3 rear, 4 left. The mixer depends on this order.'],
        check: ['Vane swings ±25° without touching the straighteners.', 'No slop between servo horn and shaft.'],
        warn: 'Wrong vane order is the most common cause of a first-flight flip. Label the wires.' },
      { title: 'Motor and propeller (propeller OFF the motor for now)', adds: ['motor', 'prop'], focus: ['motor'], time: '30 min',
        do: ['Mount the 2306 motor under the hub plate, shaft pointing DOWN, using the 16×16 pattern and thread-lock on the screws.',
             'Leave the propeller off until Gate 1 bench tests are passed. Keep it in a labelled bag.',
             'Balance the propeller on a balancer; shave or tape the heavy blade.'],
        check: ['Shaft spins freely, no rubbing.', 'Motor wires routed away from the spinning bell.'],
        warn: 'Never test a powered motor with the propeller fitted unless the shield and tether are in place.' },
      { title: 'ESC, power wiring and battery tray', adds: ['esc', 'wiring'], time: '1 h',
        do: ['Solder the XT60 lead to the ESC with the 1000 µF capacitor close to the ESC pads. Insulate with heat-shrink.',
             'Connect the three motor wires; direction is corrected later in the ESC configurator.',
             'Install the arming loop (XT30) in series with the battery lead.'],
        check: ['No shorts: continuity battery+ to battery- reads open.', 'Power-up on a 3 A current-limited supply: current stays < 0.2 A idle.'],
        warn: 'First power-up on a current-limited supply or smoke stopper, never straight from the LiPo.' },
      { title: 'Flight-computer stack', adds: ['fc'], time: '2 h',
        do: ['Solder the Teensy 4.1 sockets, IMU (SPI), barometer, INA226 and receiver headers to the carrier board.',
             'Mount the stack on four M3 nylon standoffs with silicone grommets; the IMU must be as close to the vertical axis through the CG as possible.',
             'Wire the four servos to the servo BEC rail (6 V), signal wires to the Teensy PWM pins, and the ESC signal wire to its pin. Share ground only.'],
        check: ['IMU axes match docs/phase1-monocopter/04-wiring.md.', 'Servo rail and logic rail are separate; grounds joined at one point.'] },
      { title: 'Battery, strap and balancing the airframe', adds: ['battery'], time: '30 min',
        do: ['Fit the LiPo on top of the stack with Velcro strap + foam.',
             'Check the CG: hang the vehicle on two strings at the hub plate; it should hang level. Move the battery fore/aft until it does.'],
        check: ['CG within ±3 mm of the thrust axis.', 'Battery cannot slide under a 3 g shake.'] },
      { title: 'Bench checks (no propeller)', focus: ['fc', 'servos'], time: '1 h',
        do: ['Flash the firmware (docs/phase1-monocopter/05-firmware-and-control.md). Open the serial monitor.',
             'Verify IMU: tilt the vehicle 20° left/right/forward/back; angles must change by the right sign and amount.',
             'Verify the servos: roll the airframe, the vanes must move in the direction that would push it back.',
             'Verify failsafe: switch off the transmitter, throttle must cut and vanes must centre within 0.5 s.'],
        check: ['All sign checks pass and are written in the test log.'], gate: 'Gate 0' },
      { title: 'Static thrust test on the stand', focus: ['motor', 'prop'], time: '2 h',
        do: ['Fit the propeller. Strap the airframe to the thrust stand behind a polycarbonate shield.',
             'Step throttle 10 % → 60 % while logging thrust and current. Never exceed the ESC or battery rating.',
             'Deflect vanes one at a time at 50 % throttle and record the torque to confirm authority.'],
        check: ['Max thrust ≥ 2× take-off weight.', 'Vane authority ≥ 0.02 N·m about roll and pitch at hover throttle, residual yaw torque ≤ 60 % of vane yaw authority.'], gate: 'Gate 1' },
      { title: 'Tethered hover and PID tuning', focus: ['frame-ring', 'vanes', 'prop'], time: 'several sessions',
        do: ['Three-line tether, taut enough to limit height to ≈ 1 m. Cleared area, shield for anyone nearby.',
             'Hover with attitude-hold only. Raise Kp until it oscillates, back off 30 %, then add Kd, then a little Ki.',
             'Log every flight; compare with the PID lab on the web page to understand what the plots mean.'],
        check: ['Holds ±3° for 30 s in calm air.', 'Recovers from a hand push without a crash.'], gate: 'Gate 2' },
    ],
  },

  rocket: {
    title: 'RK-1 TVC rocket - build guide',
    doc: '../docs/phase2-rocket/03-build-guide.md',
    steps: [
      { title: 'Print and prepare the structure', adds: ['rods', 'landing-frame'], focus: ['landing-frame'], time: '≈ 30 h print',
        do: ['Print every part from hardware/cad/stl/rocket (list and settings in docs/cad-parts.md). The landing frame, gimbal and cage take the loads: use PA-CF if possible, PETG for the first set.',
             'Cut four Ø6 mm carbon rods to 400 mm, deburr the ends and seal them with thin CA.',
             'Press M3 heat-set inserts in the plates, the mount, the outer ring and the struts. Ream the rod holes to Ø6.2 and the bearing bores to Ø7.0 if tight.'],
        check: ['Rods slide through all bosses without force.', 'Plates sit flat; no warp > 0.5 mm.'] },
      { title: 'Gimbal mechanics: fixed mount, outer ring, collar', adds: ['tvc'], time: '2 h',
        do: ['Press a 683ZZ bearing into each X boss of the outer ring, set the ring in the mount and fit M3 x 20 bolts from the cavity side into the nylock nut pockets on the outside of the mount.',
             'Press bearings into the collar bosses, lower the collar into the ring and fit M3 x 16 bolts from inside the collar into the nut pockets on the ring. Tighten each nut until the bearing just drags, then back off 1/8 turn.',
             'Clamp the Ø42 tube in the collar with the four set screws, then fix the mount to the four rods at the gimbal height (150 mm above the ground plane).'],
        check: ['Free swing through ±7° on both axes, no stick-slip.', 'Backlash measured with a dial gauge or phone angle app < 0.3°.'] },
      { title: 'Gear stages and servos (gear36t1, gear36t2)', adds: ['gear36t1', 'gear36t2'], time: '2 h',
        do: ['The 36-tooth sectors are part of the outer ring and the collar. Screw servo bracket 1 under the mount and bracket 2 on top of the ring (M3 x 10 into the inserts).',
             'Fit each servo in its bracket (M2 self-tap). The brackets fix the centre distance at 27 mm (pitch radii 18 + 9 mm).',
             'Centre both servos at 1500 µs, press a pinion on each spline and turn it until its tooth gap is centred on the sector tooth. Backlash: a sheet of paper between teeth is about right.',
             'Servo 2 rides on the outer ring: leave a service loop in its cable.'],
        check: ['Servo ±14° produces gimbal ±7°.', 'Gears do not skip at full deflection.'],
        warn: 'Set the gimbal software limit to 6.5° while the mechanical stop is 7°.' },
      { title: 'Motor assembly: coaxial pair and cage (props OFF)', adds: ['motor'], focus: ['motor'], time: '3 h',
        do: ['Epoxy the Ø42 tube into the upper motor plate socket and tighten its two set screws.',
             'Fit motor A under the upper plate (shaft down, screws from inside the tube bore) and motor B on the lower plate (shaft up).',
             'Bolt the six cage arms to the plate stubs, join them with the three struts and clip on the three guard arcs; the struts run outside the 114 mm prop radius.',
             'Mount the two ESCs on the tube and solder the motor leads. Do not fit the propellers: keep them in a labelled bag until Gate A is passed.',
             'Check that the assembly swings ±7° in both axes with ≥ 5 mm clearance to every part, including the legs and braces.'],
        check: ['Both motor shafts spin freely by hand.', 'Cage clears the landing frame and leg braces at full deflection.'],
        warn: 'Props stay off for every bench test. Disconnect the motor leads from the ESCs when you are testing software.' },
      { title: 'Landing gear', adds: ['landing-gear'], time: '1 h',
        do: ['Epoxy a hinge fitting on each Ø8 x 260 mm leg and hinge the legs between the lug ears of the landing frame with M3 bolts; fit rubber feet.',
             'Clip a brace clip on each leg midpoint and fit the 1.6 mm braces between the clips and the anchor holes under the gimbal mount.',
             'Check that the footprint (Ø510 mm) is level to within 2 mm.'],
        check: ['Stands upright and stable; tip-over angle > 30°.'] },
      { title: 'Battery frame: main pack and avionics pack', adds: ['battery-frame'], time: '30 min',
        do: ['Slide the battery plate onto the rods and lock it with the nuts above and below each boss.',
             'Place the foam pad, then the 6S 1500 mAh main pack and the 2S 450 mAh avionics pack side by side under the Velcro strap.',
             'Route the XT60 lead of the main pack down the rod to the power distribution board; leave a service loop.',
             'Fit the 5 A fuse in the servo BEC feed.'],
        check: ['Packs cannot move under a hard shake.', 'Fuse in place, polarity verified with a meter.'] },
      { title: 'PCB frame: flight computer', adds: ['pcb-frame'], time: '3 h',
        do: ['Assemble the flight-computer board: Teensy 4.1, IMU, barometer, servo headers, ESC signal headers, regulators, RBF pin and arm switch.',
             'Mount on brass standoffs with silicone grommets. IMU near the stack axis; axes in docs/phase2-rocket/04-wiring.md.',
             'Keep the main pack (ESCs, servo BEC) separate from the avionics pack; join grounds at one star point.'],
        check: ['Bench power-up on a current-limited supply passes with the motor leads disconnected.', 'RBF pin inserted: nothing powers.'] },
      { title: 'Telemetry plate: receiver, GPS, antenna', adds: ['telemetry-frame'], time: '1 h',
        do: ['Mount the ELRS receiver and GPS puck. Antenna vertical, ≥ 20 mm from the carbon rods.',
             'Bind the receiver to your radio and check the channel values on the console.'],
        check: ['GPS fix in < 2 min outdoors.', 'Control link solid at ≥ 100 m before any powered test.'] },
      { title: 'Gimbal sweep and calibration (Gate A, props off)', focus: ['tvc', 'gear36t1', 'gear36t2'], time: '1 h',
        do: ['Run the gimbal self-test: slow circle at ±5°, then step responses.',
             'Record the actual angle with a phone/IMU on the mount tube; fit the servo-to-gimbal map and backlash.',
             'Do the sign test: tilt the vehicle by hand and confirm the nozzle end swings away from the lean side.',
             'Compare the measured step response with the PID lab: the actuator lag you measure goes into the simulation.'],
        check: ['Measured gimbal angle within ±0.3° of commanded.', 'Step lag < 60 ms to 90 %.'], gate: 'Gate A' },
      { title: 'Thrust stand: static thrust, then gimbal sweeps under thrust', adds: ['test-stand'], focus: ['test-stand', 'motor'], time: 'one day',
        do: ['Follow docs/phase2-rocket/07-test-stand-procedure.md: shield, tether, clear zone, checklists, countdown, abort criteria.',
             'Fit the props for the first time on the stand. Step the throttle and log thrust, current and voltage (Gate B).',
             'Then sweep the gimbal open loop under thrust at hover throttle (Gate C).'],
        check: ['Thrust ≥ 2.2 × weight at ≤ 90 % throttle.', 'No loose hardware, motors and ESCs warm but not hot.'],
        warn: 'Shield between people and the props, everyone behind the safety line, arm switch in the operator\'s hand, extinguisher at the stand.', gate: 'Gate B / C' },
      { title: 'Tilting rig and tethered hover', focus: ['motor', 'tvc', 'landing-gear'], time: 'several sessions',
        do: ['Closed loop on the tilting rig first (Gate D), then on three slack tethers limiting height to about 1 m.',
             'Tune from low gains with the PID lab beside you; log every run.'],
        check: ['Holds ±3° for 30 s in calm air.', 'Recovers from a hand push without tether tension.'], gate: 'Gate D / E' },
    ],
  },
};
