JeyaVardhan-L/Single-Thrust-Vector-Controlled-Rocket/(commit log)

2026-11-10 feat: baseline TVC rocket repo with monocopter phase 1
    Docs, three.js models, interactive tutorials, BOMs, firmware core and
    Teensy skeletons, CI and Pages workflows.
    [monocopter.csv, rocket.csv]
2026-11-10 feat: 3-layer detailed rocket, catalogue-style site, remove status wording
    - Rocket stack reduced to three plates (battery, PCB, telemetry) above a diamond landing frame, with detailed components
    - Site restyled: canvas/carbon palette, hairline type, zero radius, product-grid landing page
    - Docs and BOM updated for the new stack; open-decisions renamed design-choices
    - Status/TODO wording removed from docs and code comments
    [rocket.csv]
2026-11-10 feat: electric rocket - coaxial brushless pair on the servo gimbal
    - Model: contra-rotating 9 in props, cage and guard ring, spinning props in the viewer
    - Firmware: ELRS-commanded flight states (SAFE, ARMED, FLIGHT, ABORT), coaxial mixer, gain schedule on throttle; 61 host checks
    - BOM, wiring, build wizard, sizing and gimbal labs rebuilt for the electric design
    - Phase 2 docs, safety, requirements, architecture and design choices rewritten: no solid motor, ignition or parachute
    [rocket.csv]
2026-11-10 feat: Caldera redesign, isometric line drawings, smoother models, docs viewer, procedure audit
    - Site restyled to the Caldera design (pumice/limestone, ember, pill controls, 40px surfaces, Anton + DM Sans)
    - Home page: halftone hero with an isometric line drawing, stat cards, isometric model cards
    - Docs readable on the site (web/doc.html, vendored marked); UI audit script (console, requests, text contrast)
    - Models: bevelled boxes, higher-segment geometry, studio environment lighting, light stage
    - Fixed unreadable text, PID lab slider ranges, wizard highlight colour
    - Procedure audit: prop orientation (pusher/standard), wording, BOM notes
    [monocopter.csv, rocket.csv]
2026-11-10 perf: smooth home page; hero beside headline; free viewer camera
    - Home drawings render only when visible; cards render once; hero capped at 24 fps; lighter geometry for the drawings
    - Hero model sits beside the headline
    - Viewer: orbit below the ground, pan, zoom to cursor, focus on the selected part, quick views (gimbal, motors, underside, stack)
2026-11-10 feat: printable STL parts for RK-1 (18 files), parametric generator, assembly interference check, parts page
    - scripts/cad: manifold-based parametric parts (stack plates, landing frame, gimbal mount/ring/collar with 36T sectors, pinions, servo brackets, motor plates, cage arms/struts/guard arcs, leg hinges and clips)
    - hardware/cad/stl/rocket: binary STL in print orientation, parts.json manifest, docs/cad-parts.md
    - npm run cad / cad:check / cad:assembly; tests for closed solids, dimensions and zero interference at nine gimbal poses; CI check
    - build guide, wizard steps, gimbal design, printing guide, BOM (pivot hardware, 400 mm rods, 260 mm legs) updated to the printed parts
    - web/parts.htm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
    [cage-arm-lower.stl, cage-arm-upper.stl, cage-strut.stl, gimbal-collar.stl, gimbal-mount.stl, gimbal-ring.stl, guard-arc.stl, landing-frame.stl]
